OH2LAK/HamRef/docs/datasheets/OLED_0.91_I2C_proto/71N2hJt965L._SL1500_.jpg

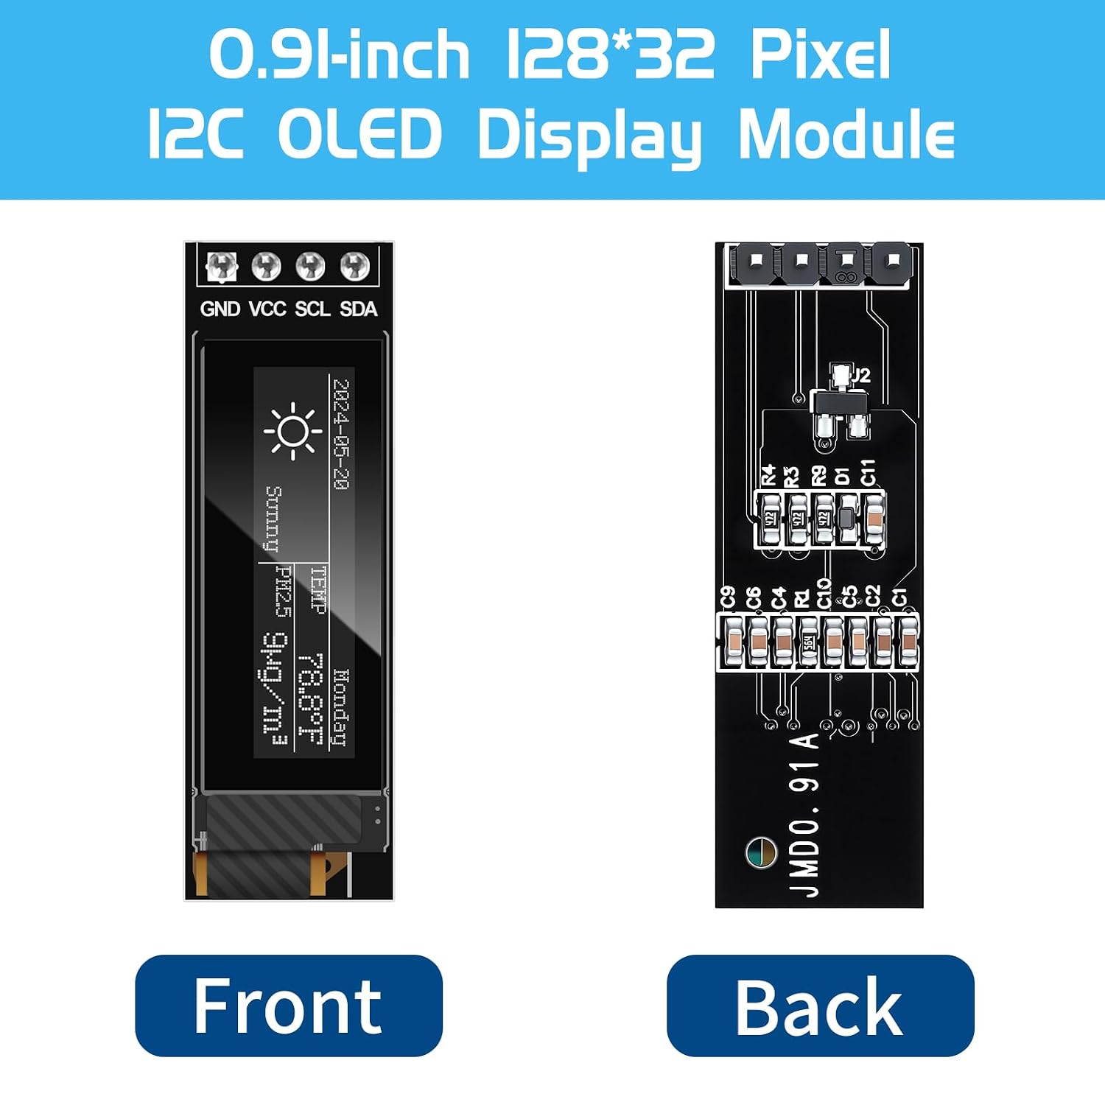
docs/datasheets/OLED_0.91_I2C_proto/71N2hJt965L._SL1500_.jpg
