OH2LAK/HamRef/docs/datasheets/OLED_0.91_I2C_proto/71uFmHMnJsL._SL1500_.jpg

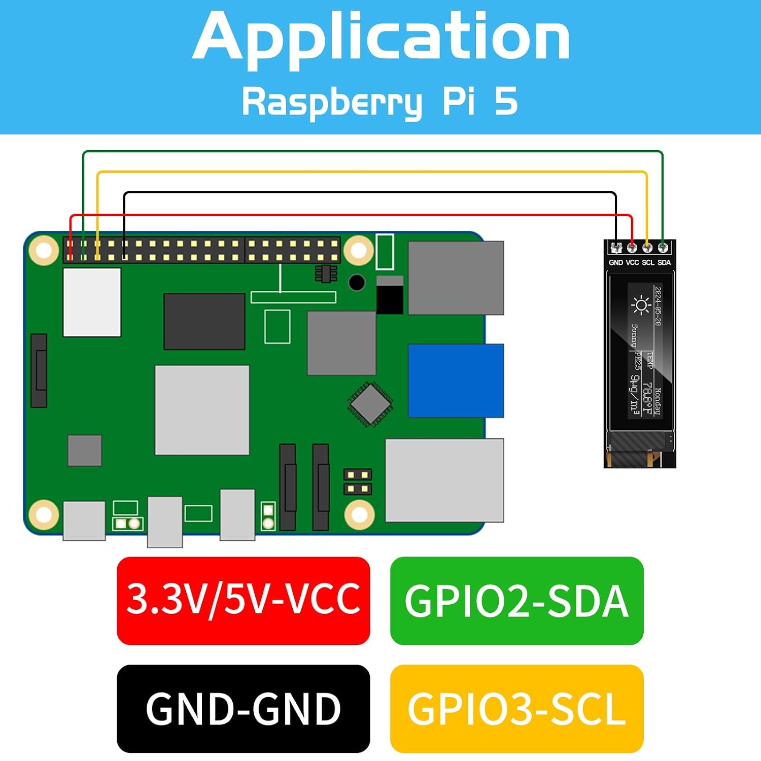
docs/datasheets/OLED_0.91_I2C_proto/71uFmHMnJsL._SL1500_.jpg
