OH2LAK/HamRef/docs/images/HamREF proto-1 PCB.png

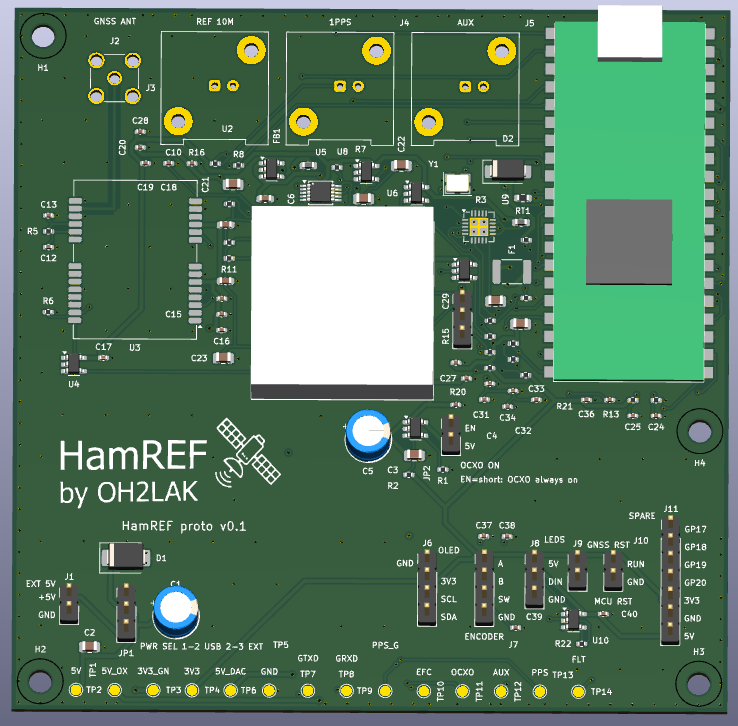
docs/images/HamREF proto-1 PCB.png
