OH2LAK/HamRef/hardware/proto-v0.1/hamref_proto_v0_1_schematic.pdf

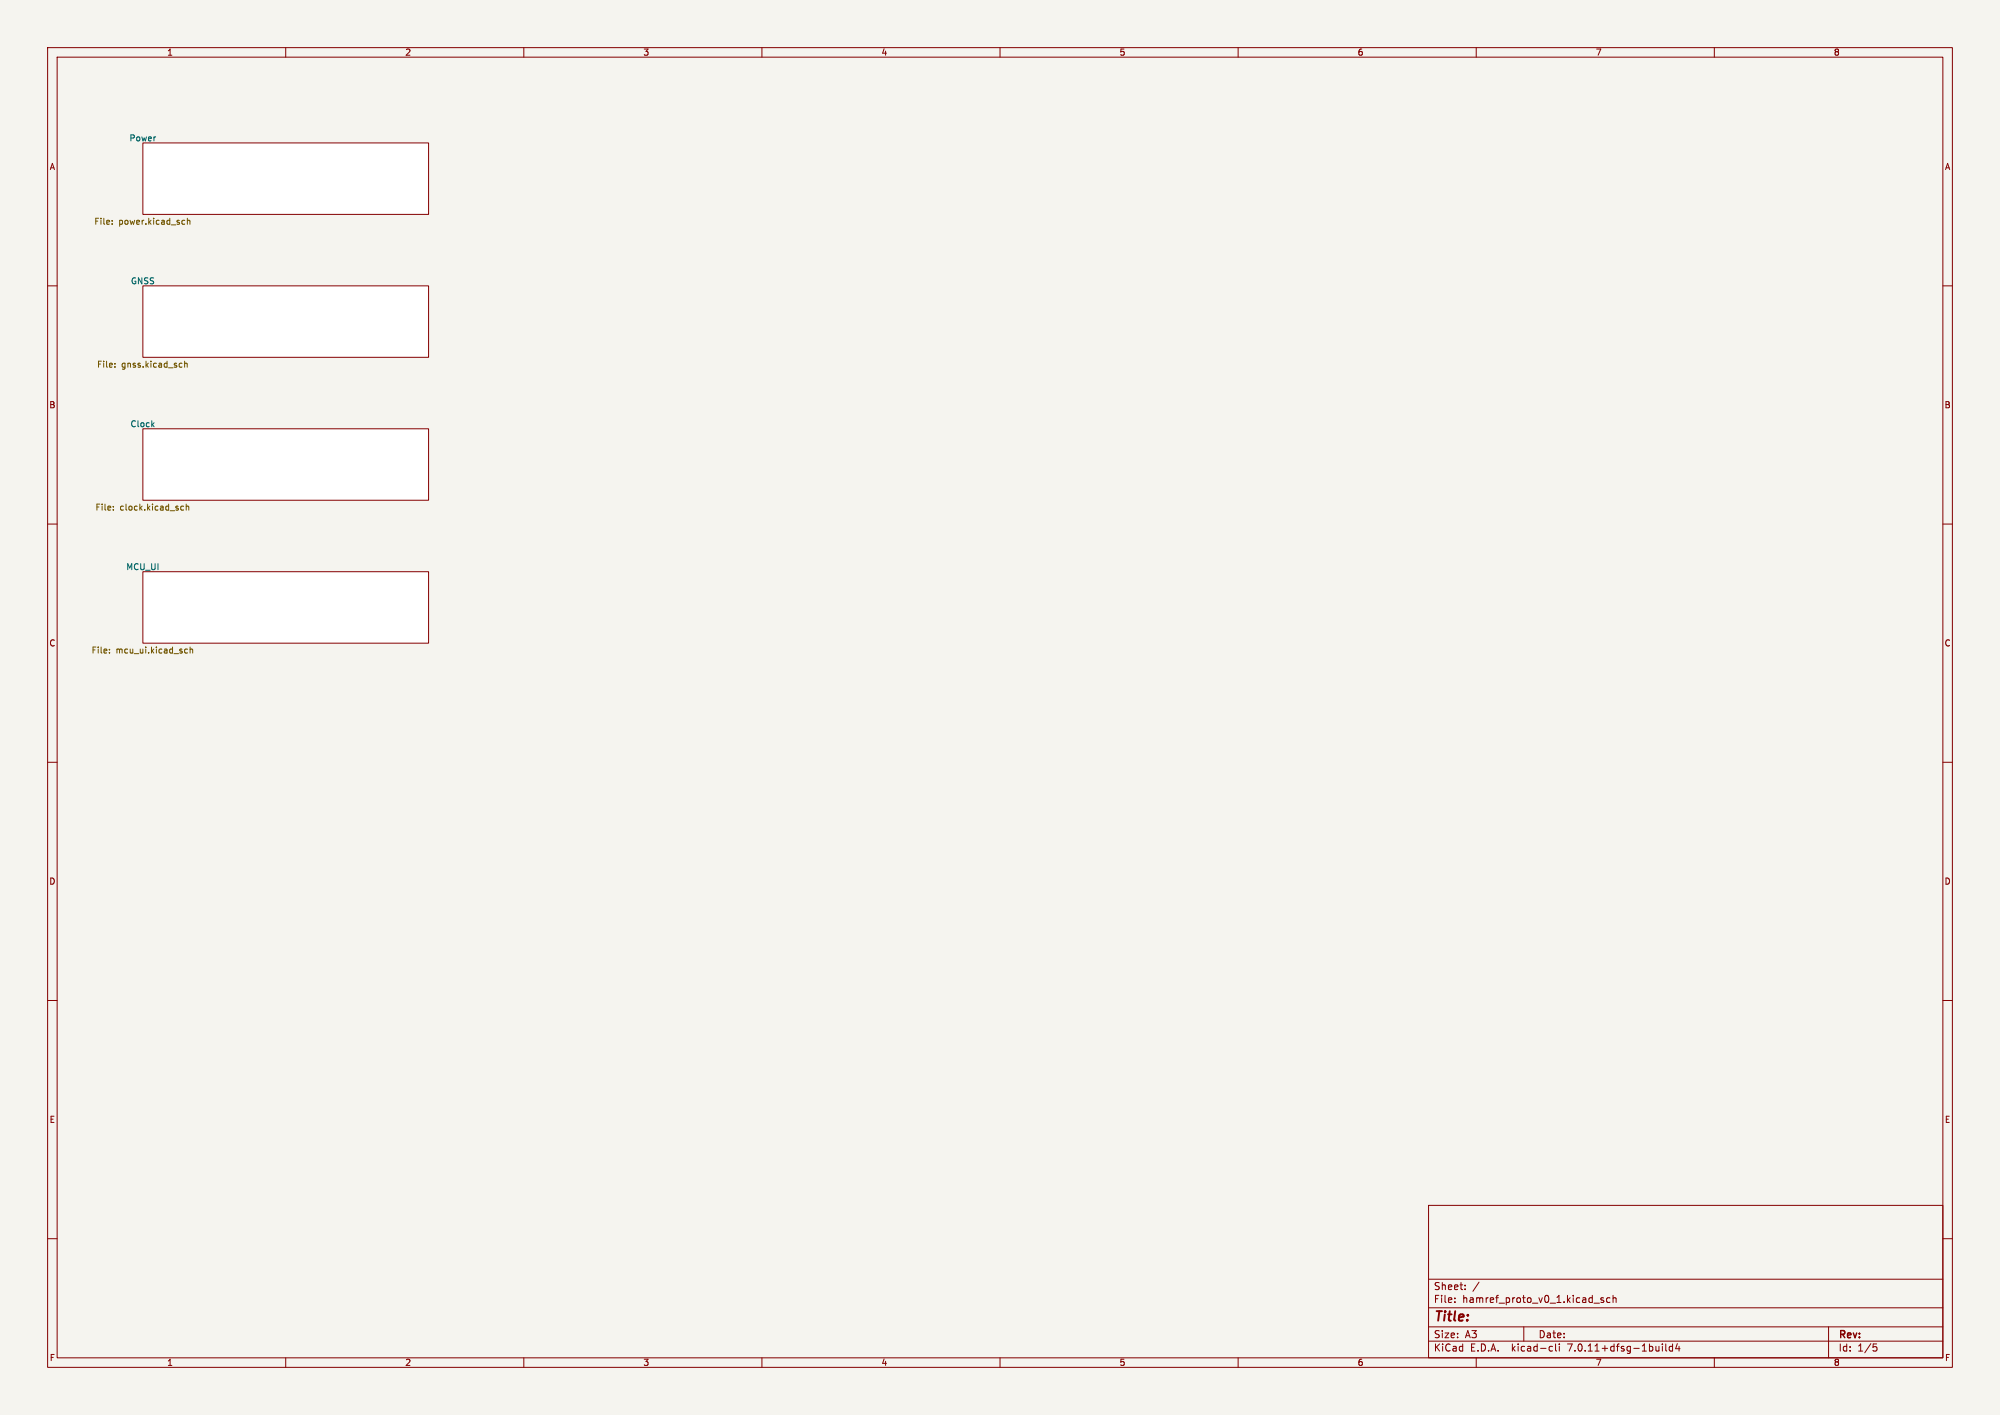
[picture p12: page 1]

Power File: power.kicad_sch GNSS

File: gnss.kicad_sch Clock File: clock.kicad_sch MCU_UI File: mcu_ui.kicad_sch

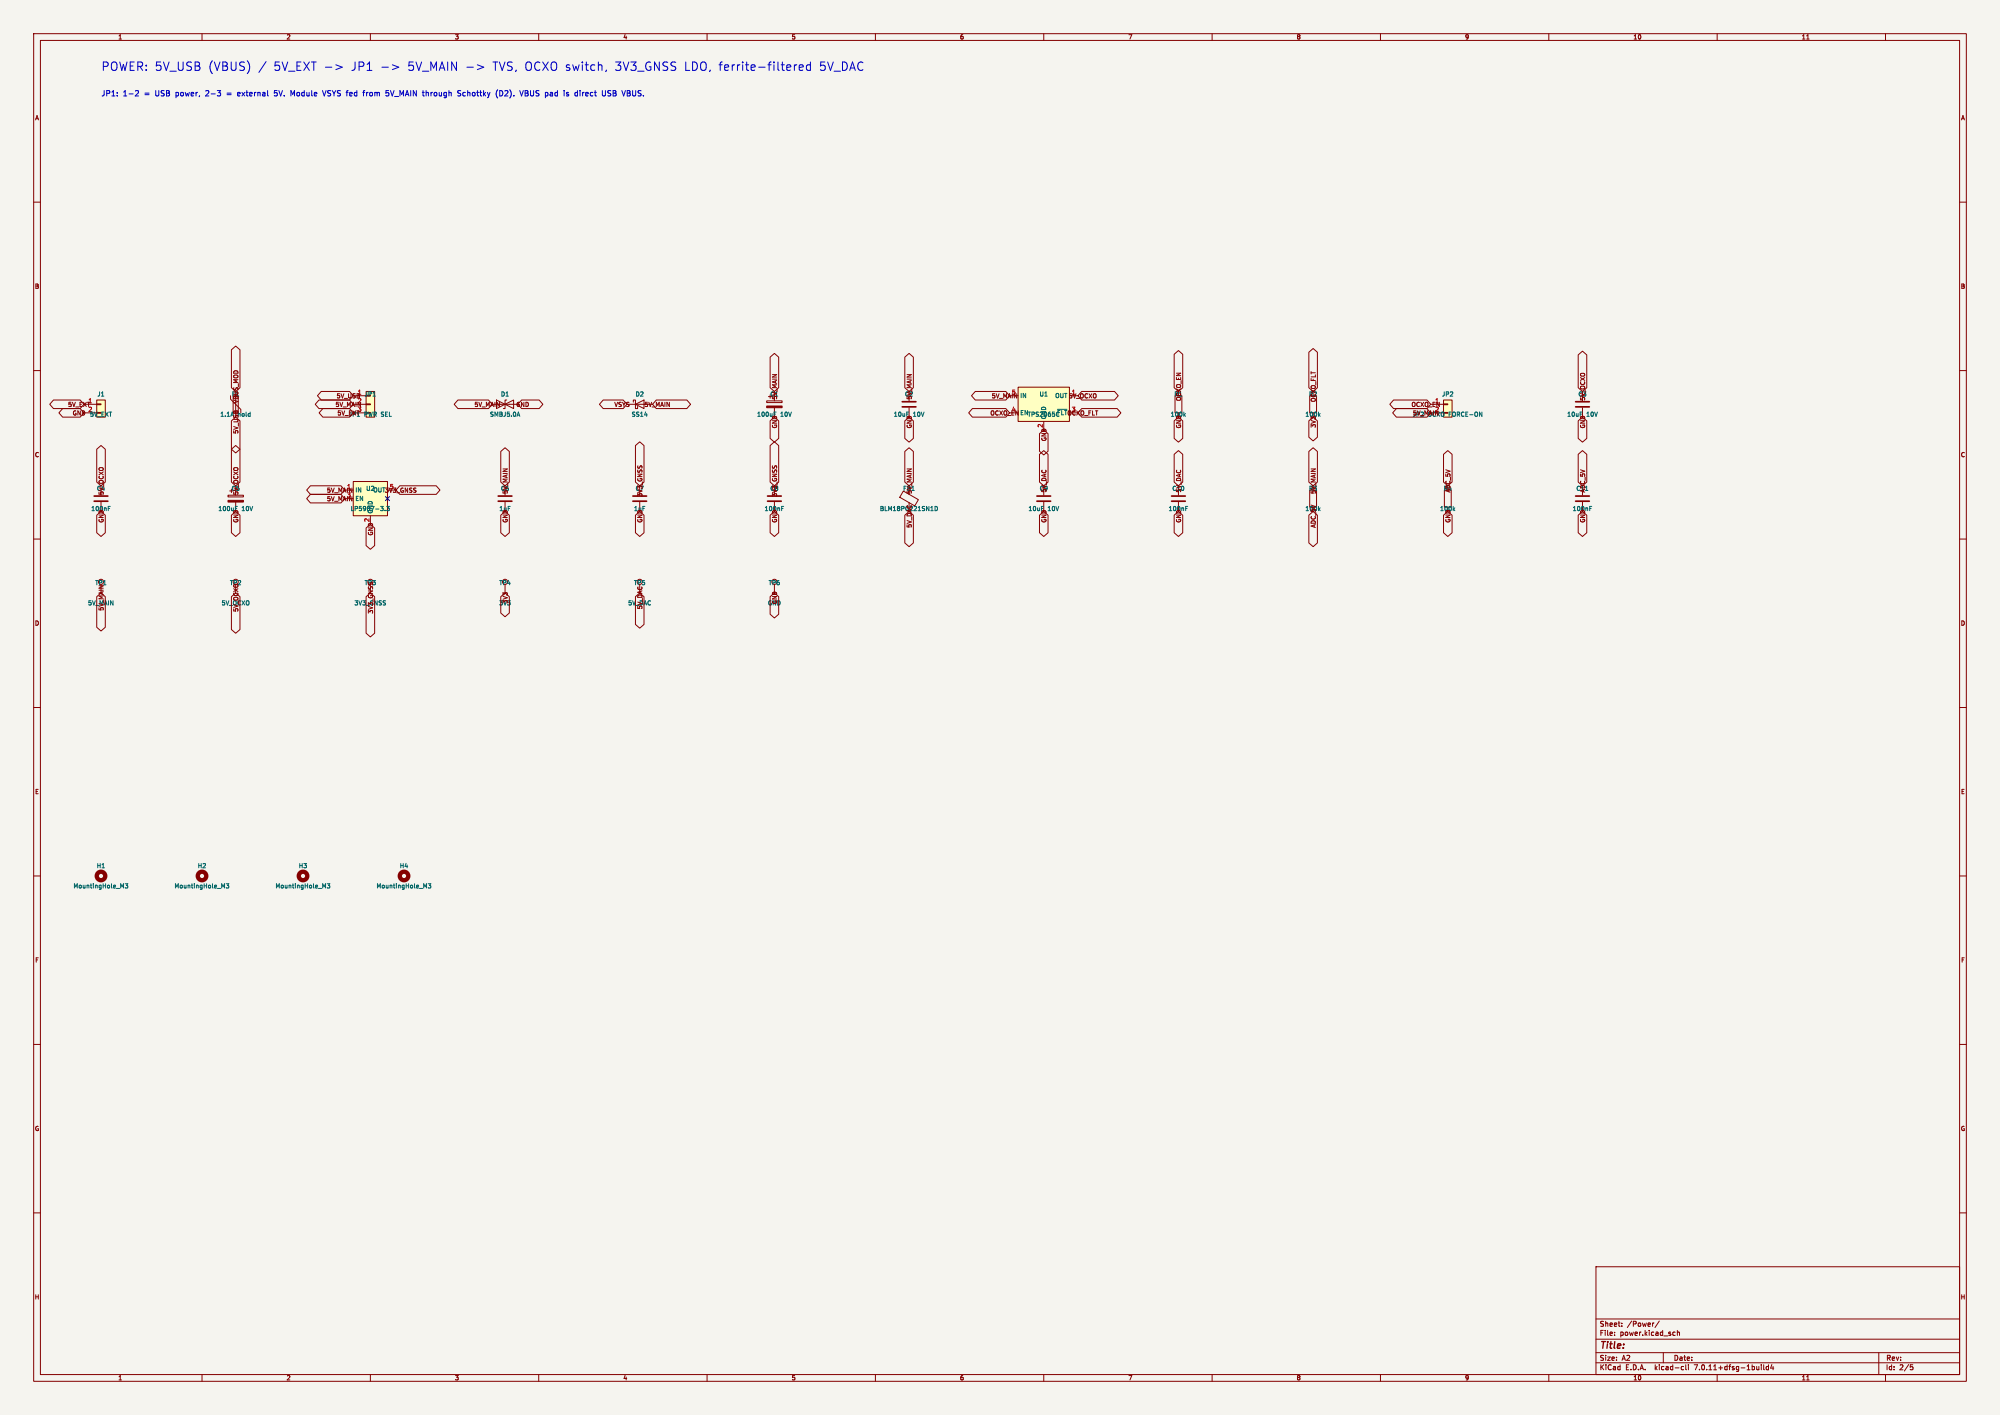
[picture p13: page 2]

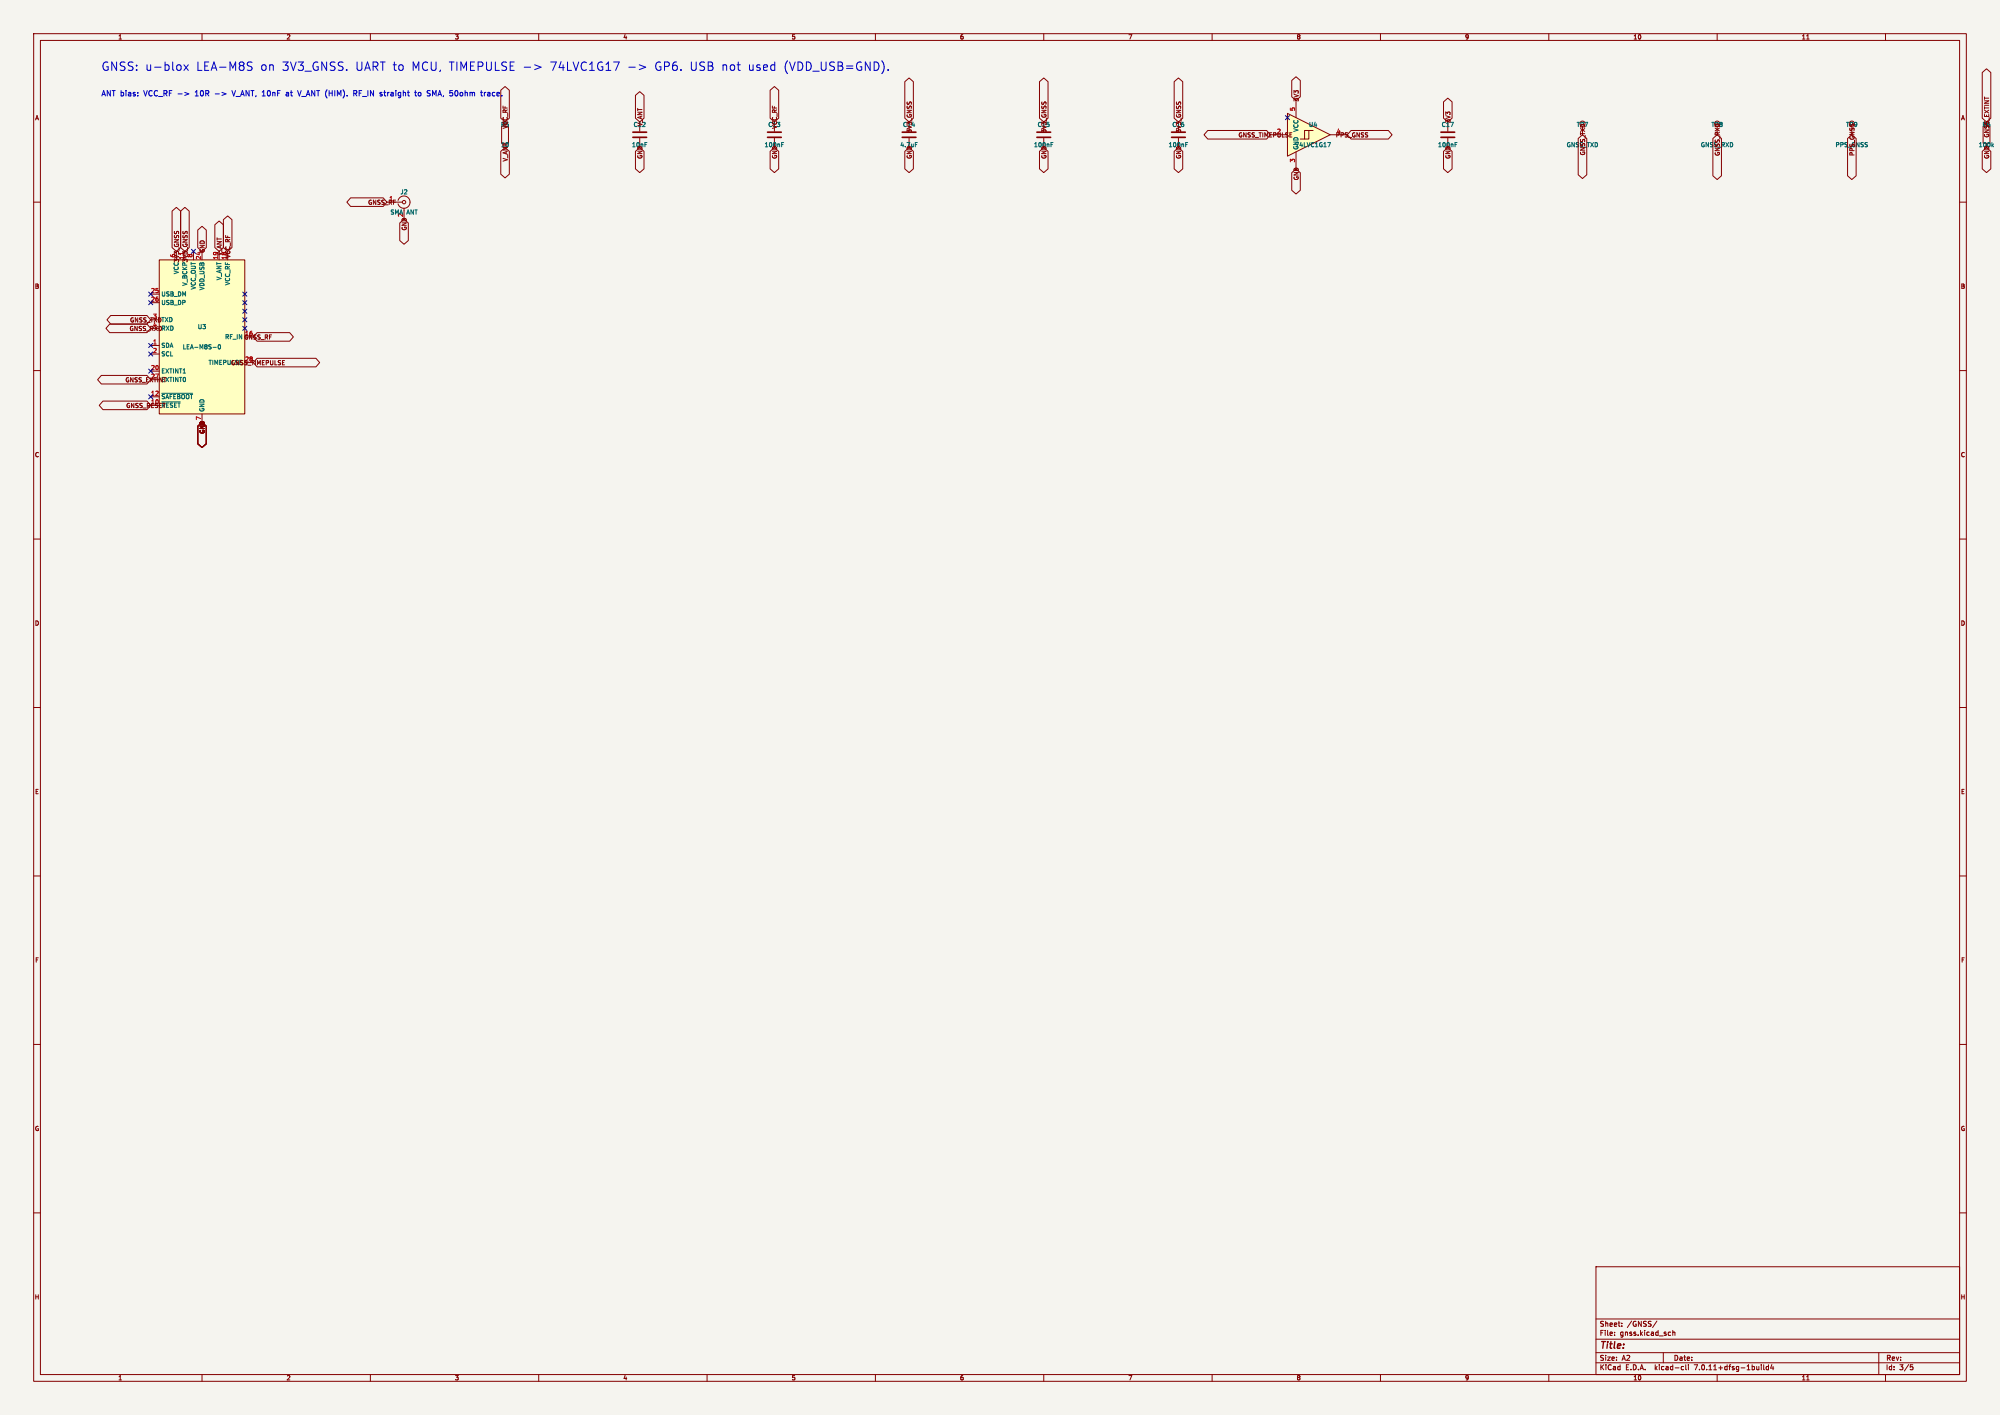
[picture p14: page 3]

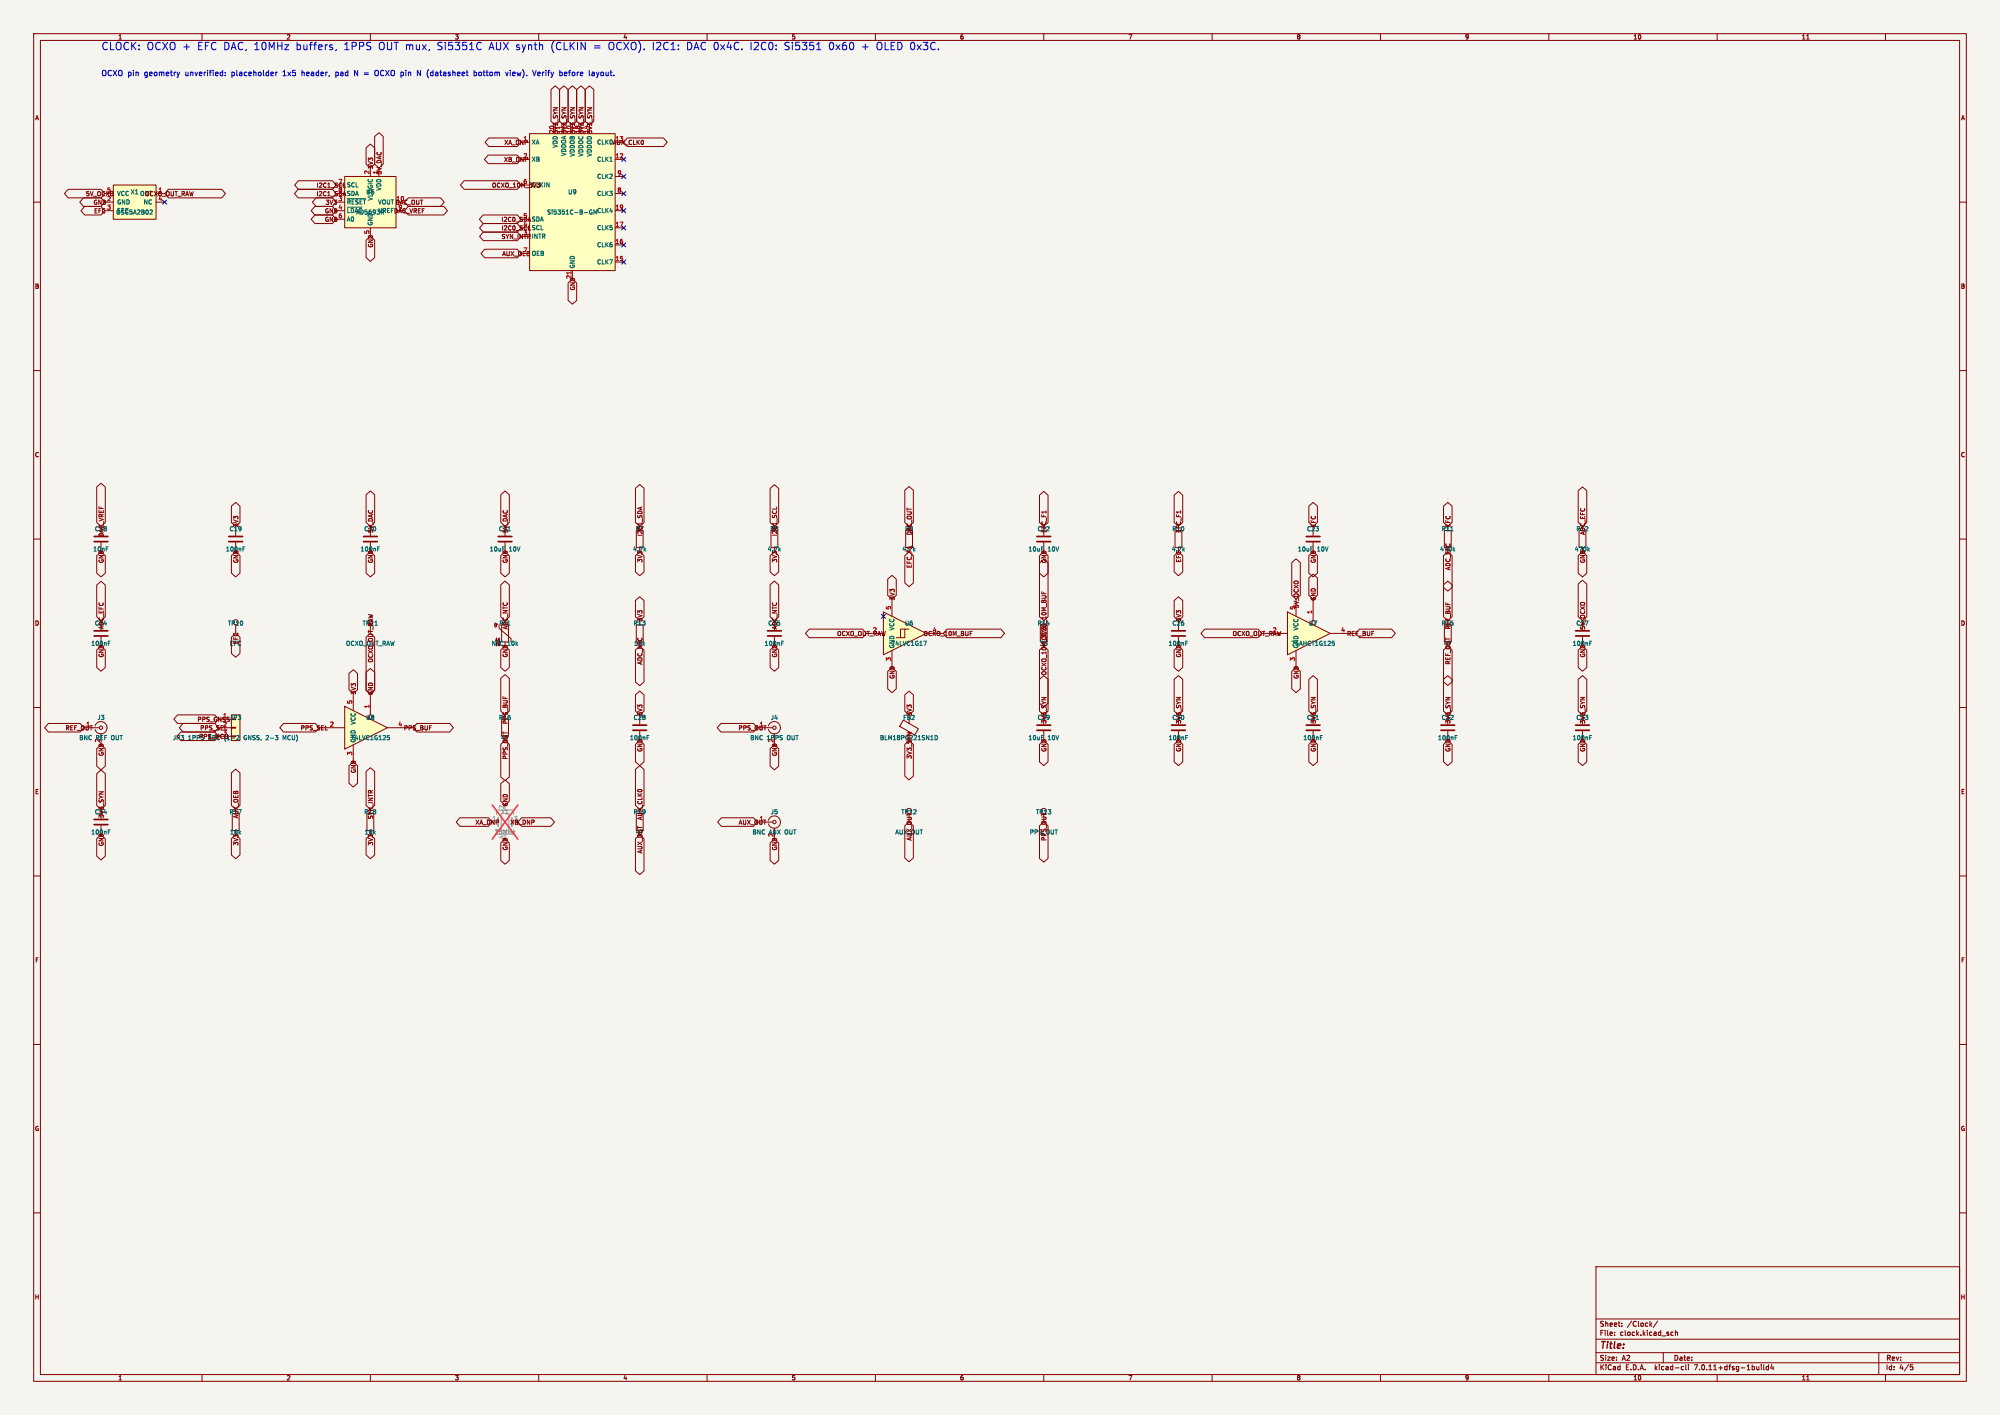
[picture p15: page 4]

CLOCK: OCXO + EFC DAC, 10MHz buffers, 1PPS OUT mux, Si5351C AUX synth (CLKIN = OCXO). I2C1: DAC 0x4C. I2C0: Si5351 0x60 + OLED 0x3C.

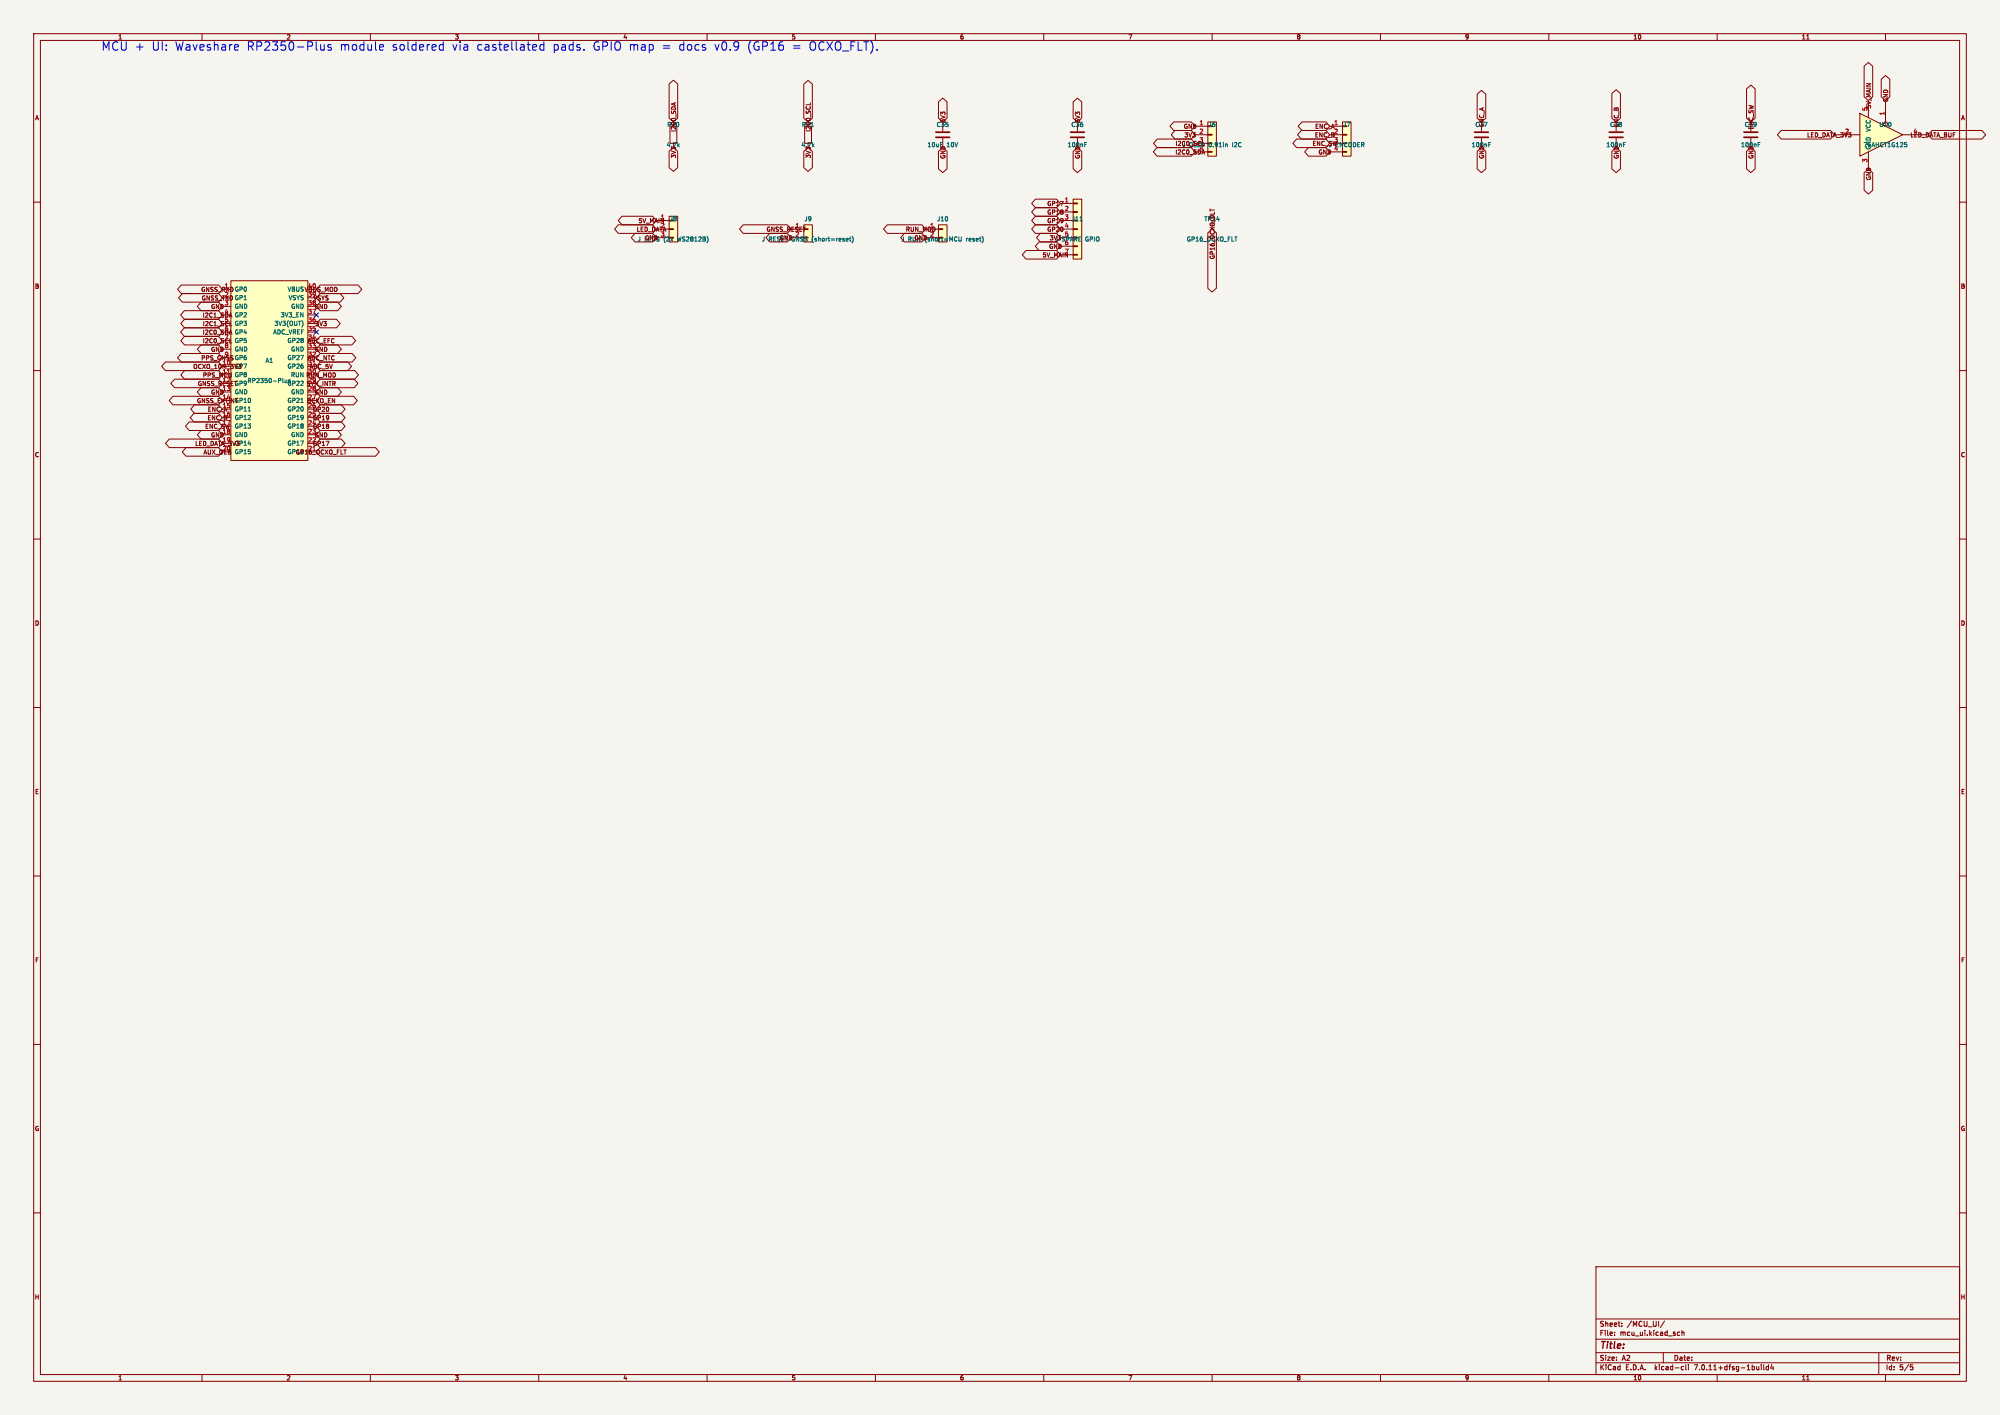
[picture p16: page 5]
