OH2LAK/HamRef/hardware/proto-v0.1/hamref_proto_v0_1_pcb.pdf

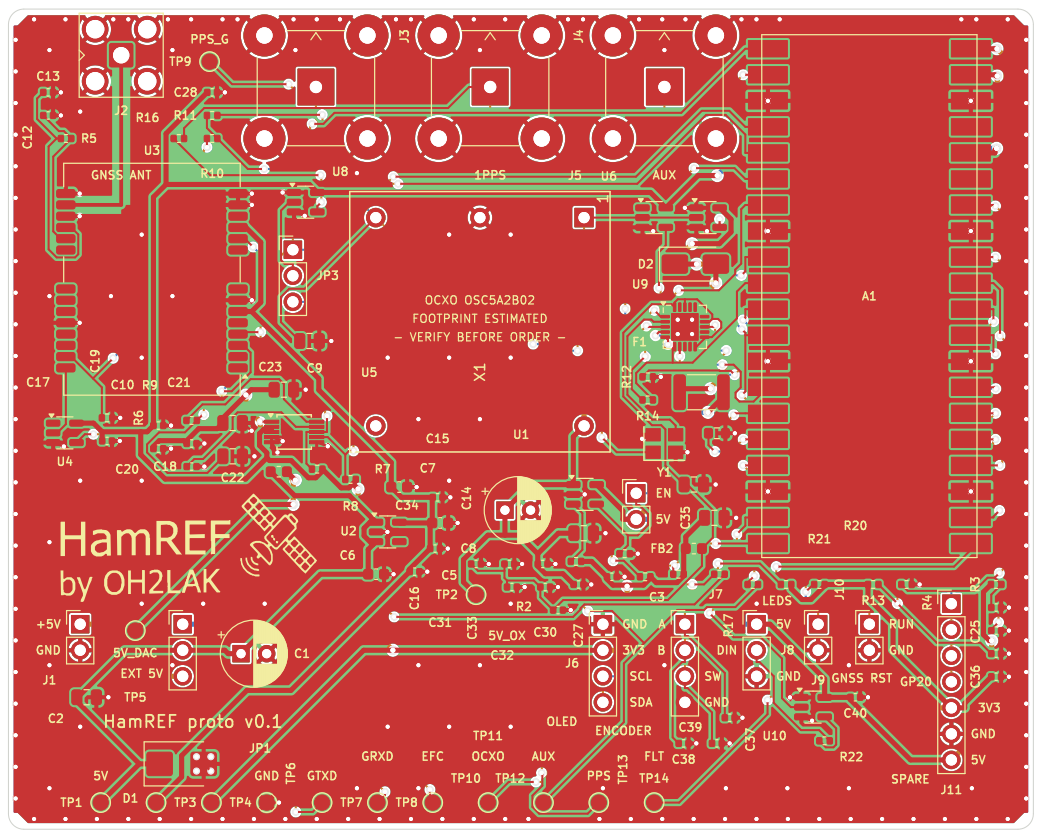
[picture p17: page 1]
