OH2LAK/HamRef/hardware/proto-v0.1/hamref_proto_v0_1.kicad_pcb

## KiCad design hardware/proto-v0.1/hamref_proto_v0_1.kicad_pcb (2026-10-14)

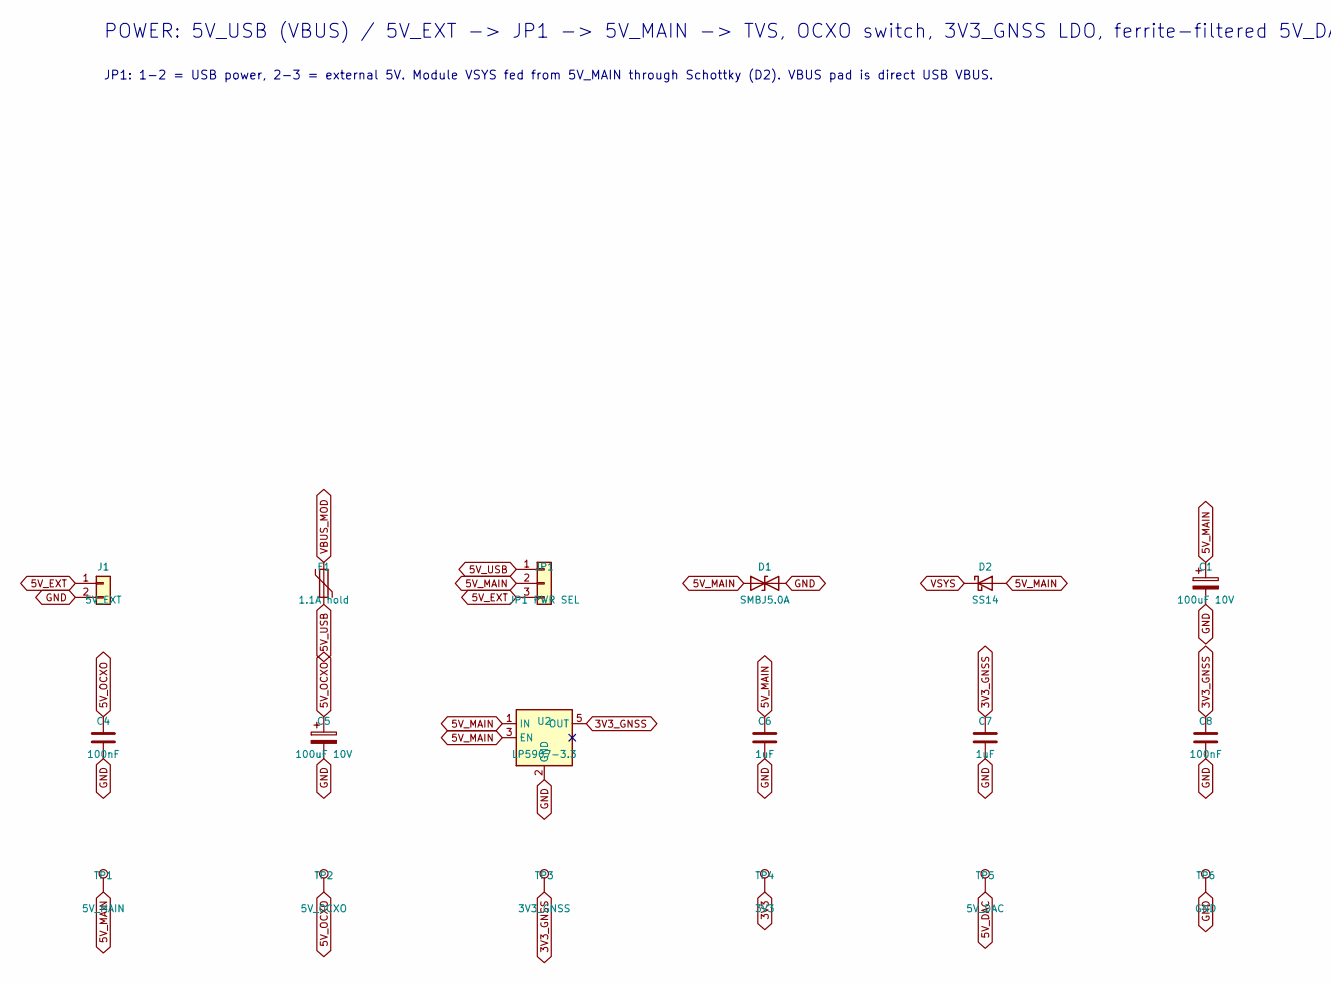
[picture p18: schematic power.kicad_sch, part in row 1, column 1]

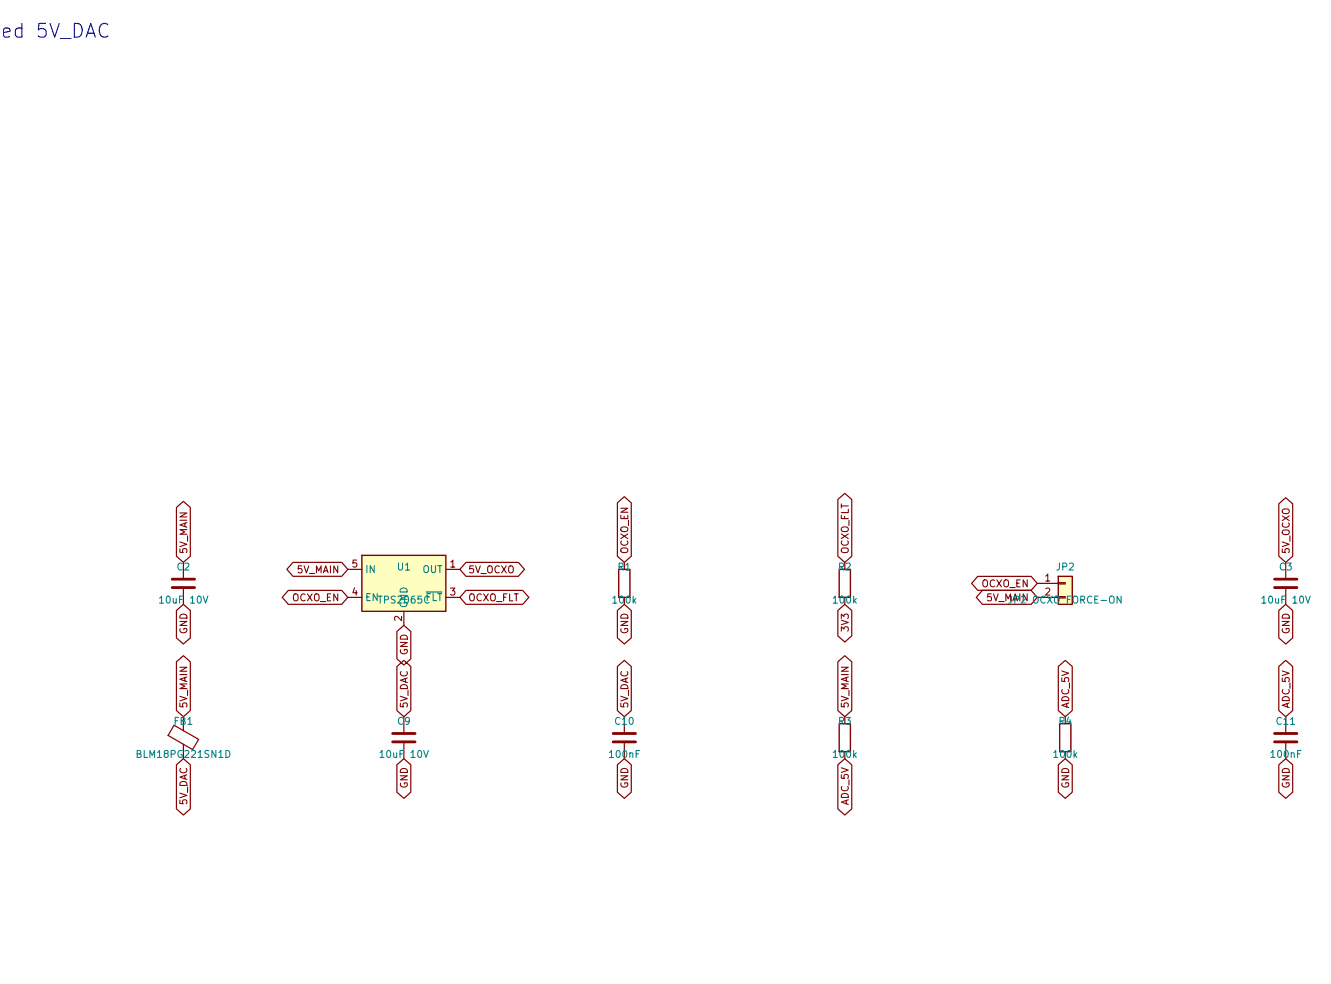
[picture p19: schematic power.kicad_sch, part in row 1, column 2]

Parts:
C1, C5: 100uF 10V; CP_Radial_D6.3mm_P2.50mm
C2, C3, C9: 10uF 10V; C_0805_2012Metric
C4, C8, C10, C11: 100nF; C_0402_1005Metric
C6, C7: 1uF; C_0603_1608Metric
D1: SMBJ5.0A; D_SMB; MPN SMBJ5.0A
D2: SS14; D_SMA; MPN SS14
F1: 1.1A hold; Fuse_1812_4532Metric; MPN MF-MSMF110/16X-2
FB1: BLM18PG221SN1D; L_0603_1608Metric; MPN BLM18PG221SN1D
J1: 5V_EXT; PinHeader_1x02_P2.54mm_Vertical
JP1: JP1 PWR SEL; PinHeader_1x03_P2.54mm_Vertical
JP2: JP2 OCXO FORCE-ON; PinHeader_1x02_P2.54mm_Vertical
R1, R2, R3, R4: 100k; R_0402_1005Metric
TP1: 5V_MAIN; TestPoint_Pad_D1.5mm
TP2: 5V_OCXO; TestPoint_Pad_D1.5mm
TP3: 3V3_GNSS; TestPoint_Pad_D1.5mm
TP4: 3V3; TestPoint_Pad_D1.5mm
TP5: 5V_DAC; TestPoint_Pad_D1.5mm
TP6: GND; TestPoint_Pad_D1.5mm
U1: TPS2065C; SOT-23-5; MPN TPS2065CDBVR
U2: LP5907-3.3; SOT-23-5; MPN LP5907MFX-3.3/NOPB

Connections:
3V3: R2.2, TP4.1; also elsewhere on the board
3V3_GNSS: C7.1, C8.1, TP3.1, U2.5 (OUT); also elsewhere on the board
5V_DAC: C9.1, C10.1, FB1.2, TP5.1; also elsewhere on the board
5V_EXT: J1.1, JP1.3
5V_MAIN: C1.1, C2.1, C6.1, D1.1 (A1), D2.2 (A), FB1.1, JP1.2, JP2.2, R3.1, TP1.1, U1.5 (IN), U2.1 (IN), U2.3 (EN); also elsewhere on the board
5V_OCXO: C3.1, C4.1, C5.1, TP2.1, U1.1 (OUT); also elsewhere on the board
5V_USB: F1.2, JP1.1
ADC_5V: C11.1, R3.2, R4.1; also elsewhere on the board
GND: C1.2, C2.2, C3.2, C4.2, C5.2, C6.2, C7.2, C8.2, C9.2, C10.2, C11.2, D1.2 (A2), J1.2, R1.2, R4.2, TP6.1, U1.2 (GND), U2.2 (GND); also elsewhere on the board
OCXO_EN: JP2.1, R1.1, U1.4 (EN); also elsewhere on the board
OCXO_FLT: R2.1, U1.3 (~FLT)
VBUS_MOD: F1.1; also elsewhere on the board
VSYS: D2.1 (K); also elsewhere on the board

Notes on the sheet:
POWER: 5V_USB (VBUS) / 5V_EXT -> JP1 -> 5V_MAIN -> TVS, OCXO switch, 3V3_GNSS LDO, ferrite-filtered 5V_DAC
JP1: 1-2 = USB power, 2-3 = external 5V. Module VSYS fed from 5V_MAIN through Schottky (D2). VBUS pad is direct USB VBUS.

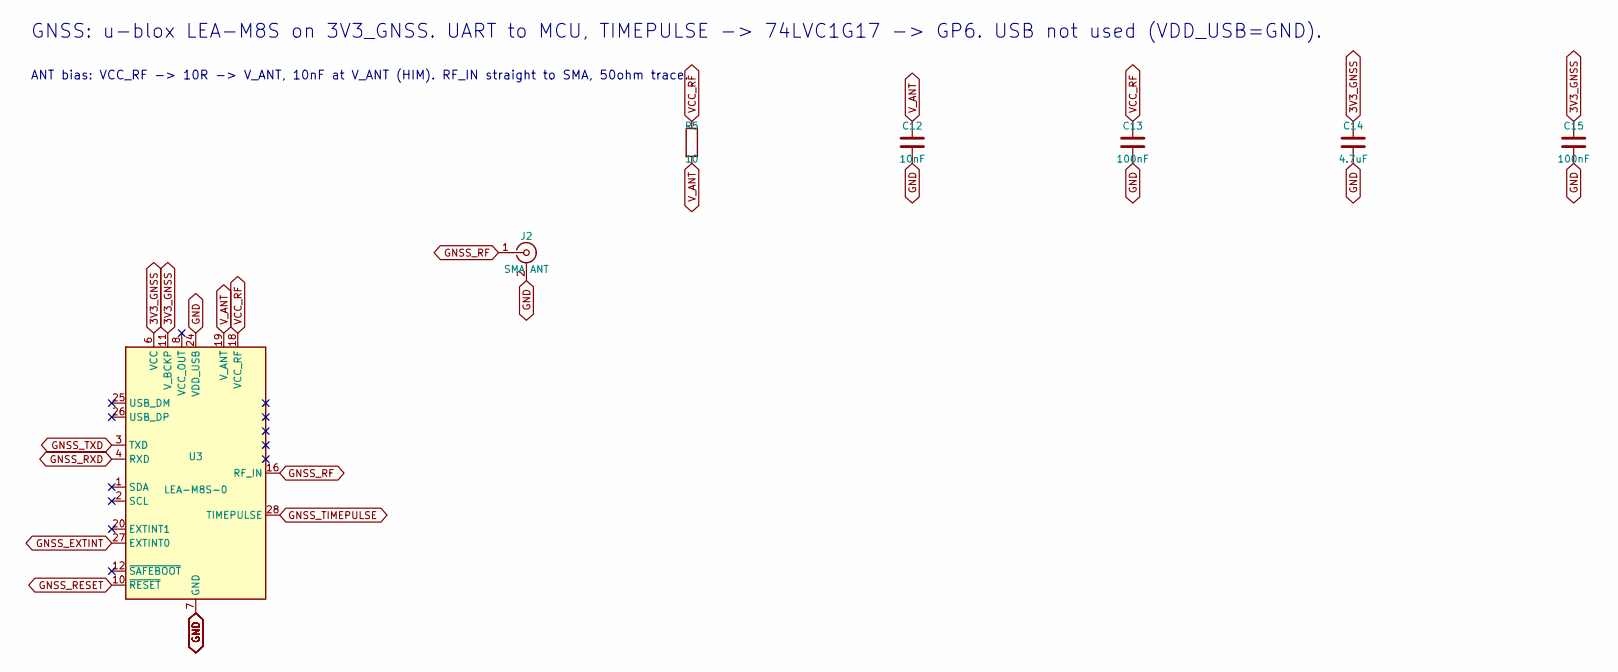
[picture p20: schematic gnss.kicad_sch, part in row 1, column 1]

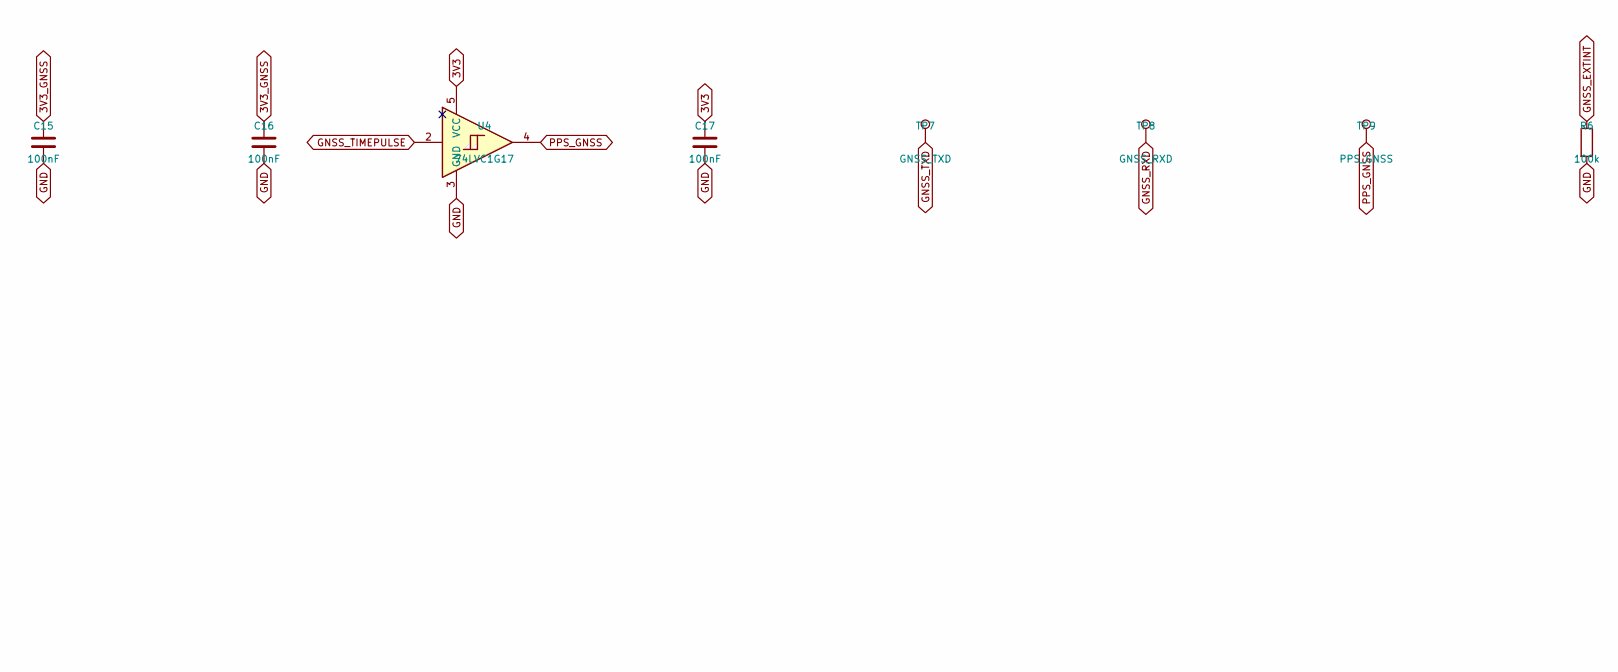
[picture p21: schematic gnss.kicad_sch, part in row 1, column 2]

Parts:
C12: 10nF; C_0402_1005Metric
C13, C15, C16, C17: 100nF; C_0402_1005Metric
C14: 4.7uF; C_0603_1608Metric
J2: SMA ANT; SMA_Amphenol_901-143_Horizontal; MPN 901-143
R5: 10; R_0402_1005Metric
R6: 100k; R_0402_1005Metric
TP7: GNSS_TXD; TestPoint_Pad_D1.5mm
TP8: GNSS_RXD; TestPoint_Pad_D1.5mm
TP9: PPS_GNSS; TestPoint_Pad_D1.5mm
U3: LEA-M8S-0; ublox_LEA; MPN LEA-M8S-0-10
U4: 74LVC1G17; SOT-23-5; MPN SN74LVC1G17DBVR

Connections:
3V3: C17.1, U4.5 (VCC); also elsewhere on the board
3V3_GNSS: C14.1, C15.1, C16.1, U3.6 (VCC), U3.11 (V_BCKP); also elsewhere on the board
GND: C12.2, C13.2, C14.2, C15.2, C16.2, C17.2, J2.2 (Ext), R6.2, U3.7 (GND), U3.13 (GND), U3.14 (GND), U3.15 (GND), U3.17 (GND), U3.24 (VDD_USB), U4.3 (GND); also elsewhere on the board
GNSS_EXTINT: R6.1, U3.27 (EXTINT0); also elsewhere on the board
GNSS_RESET: U3.10 (~RESET); also elsewhere on the board
GNSS_RF: J2.1 (In), U3.16 (RF_IN)
GNSS_RXD: TP8.1, U3.4 (RXD); also elsewhere on the board
GNSS_TIMEPULSE: U3.28 (TIMEPULSE), U4.2
GNSS_TXD: TP7.1, U3.3 (TXD); also elsewhere on the board
PPS_GNSS: TP9.1, U4.4; also elsewhere on the board
VCC_RF: C13.1, R5.1, U3.18 (VCC_RF)
V_ANT: C12.1, R5.2, U3.19 (V_ANT)

Notes on the sheet:
GNSS: u-blox LEA-M8S on 3V3_GNSS. UART to MCU, TIMEPULSE -> 74LVC1G17 -> GP6. USB not used (VDD_USB=GND).
ANT bias: VCC_RF -> 10R -> V_ANT, 10nF at V_ANT (HIM). RF_IN straight to SMA, 50ohm trace.

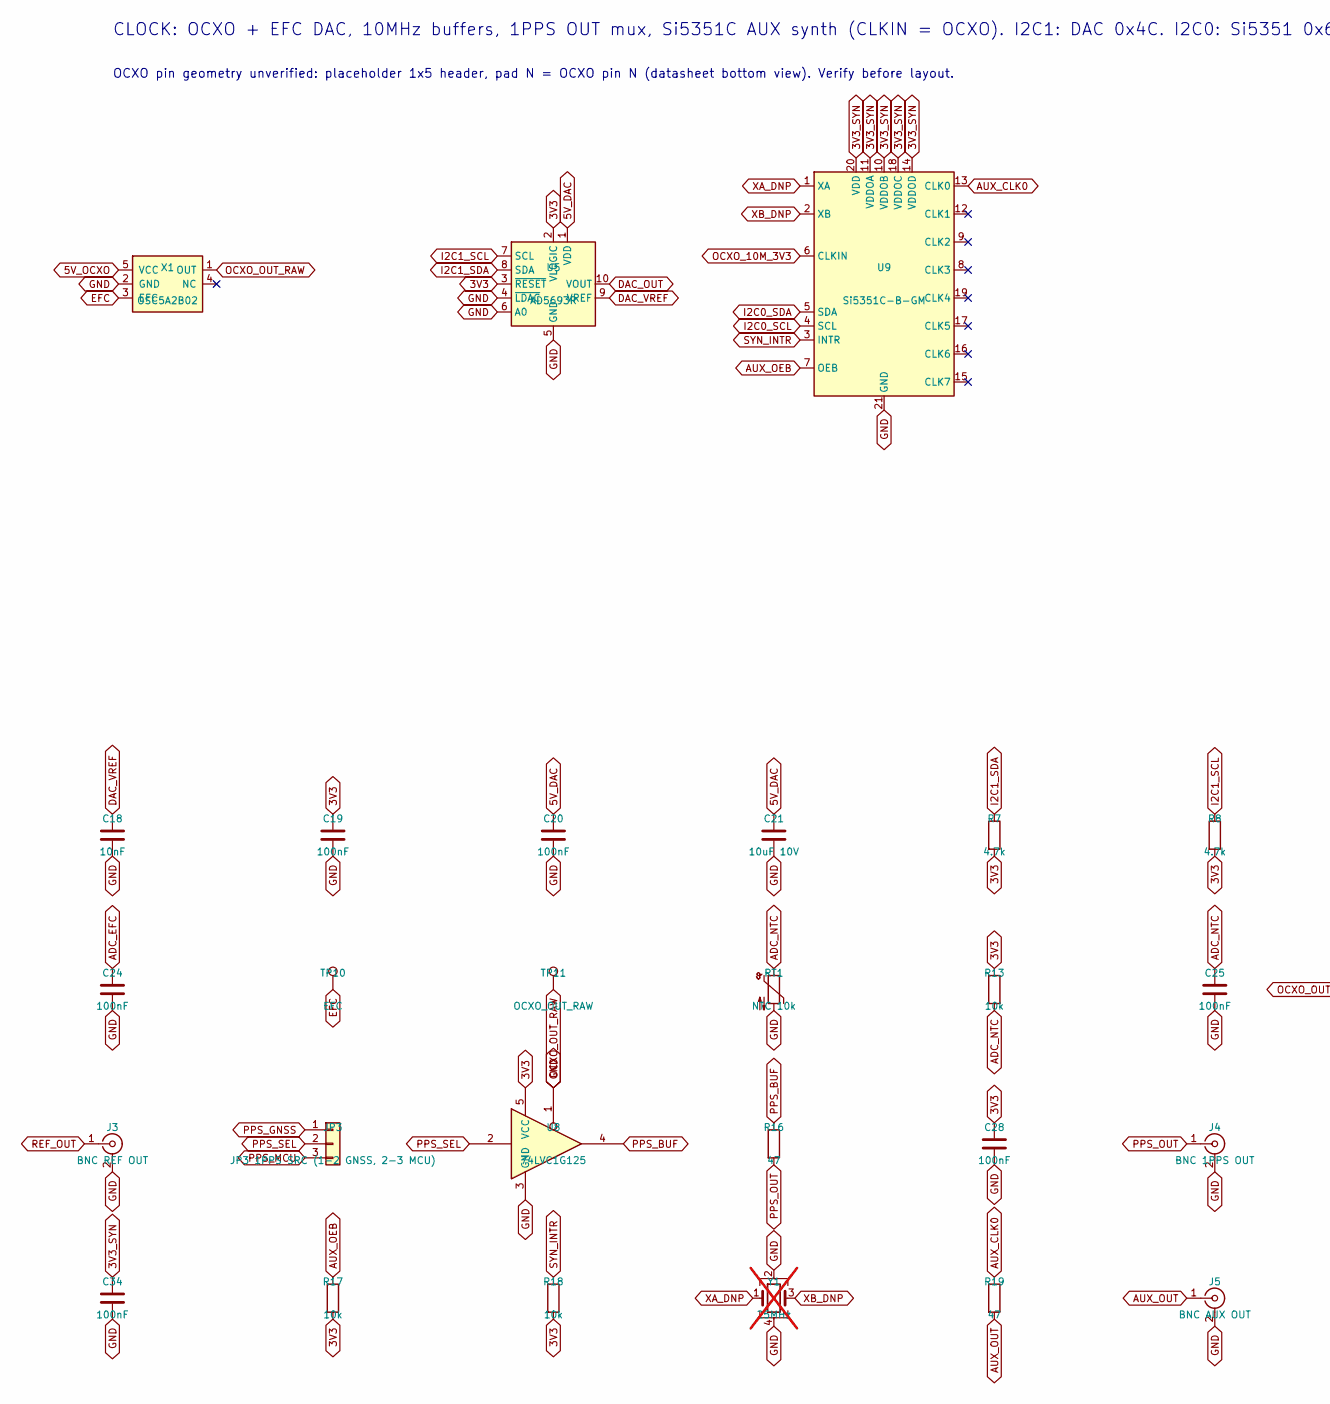
[picture p22: schematic clock.kicad_sch, part in row 1, column 1]

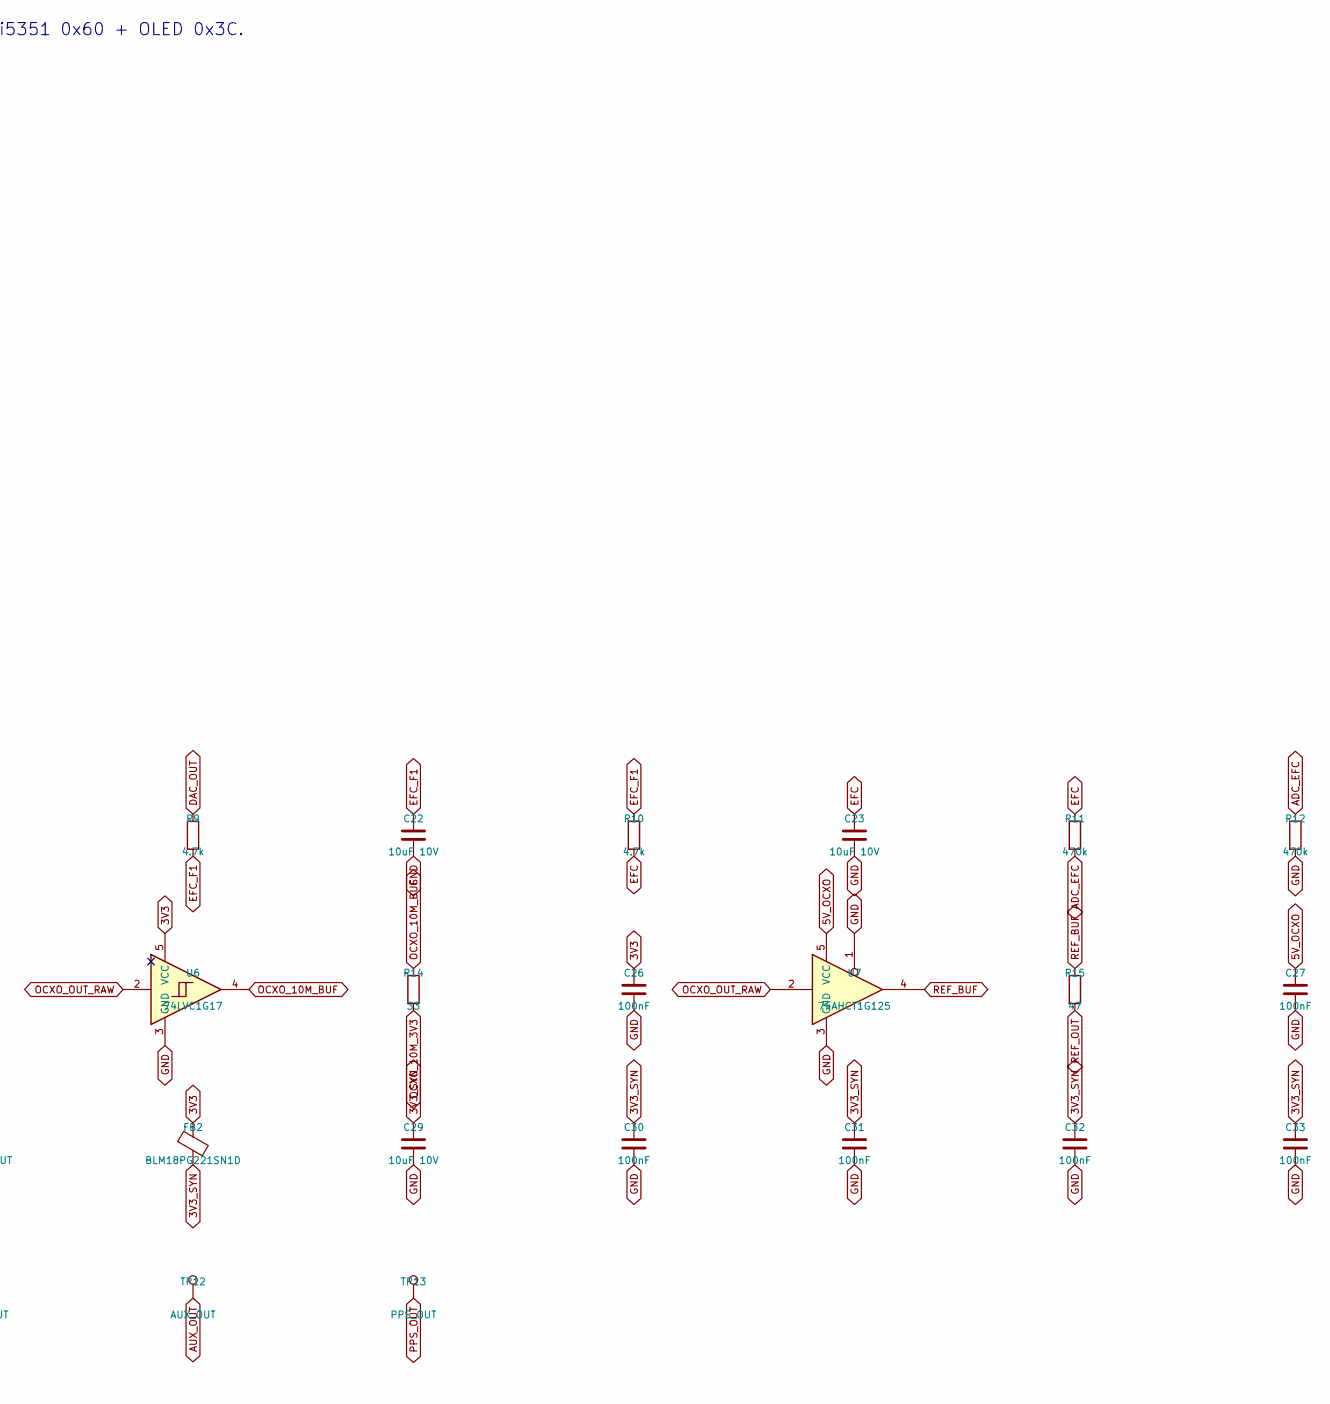
[picture p23: schematic clock.kicad_sch, part in row 1, column 2]

Parts:
C18: 10nF; C_0402_1005Metric
C19, C20, C24, C25, C26, C27, C28, C30, C31, C32, C33, C34: 100nF; C_0402_1005Metric
C21, C22, C23, C29: 10uF 10V; C_0805_2012Metric
FB2: BLM18PG221SN1D; L_0603_1608Metric; MPN BLM18PG221SN1D
J3: BNC REF OUT; BNC_TEConnectivity_1478035_Horizontal; MPN 1-1478035-0
J4: BNC 1PPS OUT; BNC_TEConnectivity_1478035_Horizontal; MPN 1-1478035-0
J5: BNC AUX OUT; BNC_TEConnectivity_1478035_Horizontal; MPN 1-1478035-0
JP3: JP3 1PPS SRC (1-2 GNSS, 2-3 MCU); PinHeader_1x03_P2.54mm_Vertical
R7, R8, R9, R10: 4.7k; R_0402_1005Metric
R11, R12: 470k; R_0402_1005Metric
R13, R17, R18: 10k; R_0402_1005Metric
R14: 33; R_0402_1005Metric
R15, R16, R19: 47; R_0402_1005Metric
RT1: NTC 10k; R_0603_1608Metric; MPN NCP18XH103F03RB
TP10: EFC; TestPoint_Pad_D1.5mm
TP11: OCXO_OUT_RAW; TestPoint_Pad_D1.5mm
TP12: AUX_OUT; TestPoint_Pad_D1.5mm
TP13: PPS_OUT; TestPoint_Pad_D1.5mm
U5: AD5693R; MSOP-10_3x3mm_P0.5mm; MPN AD5693RBRMZ
U6: 74LVC1G17; SOT-23-5; MPN SN74LVC1G17DBVR
U7: 74AHCT1G125; SOT-23-5; MPN SN74AHCT1G125DBVR
U8: 74LVC1G125; SOT-23-5; MPN SN74LVC1G125DBVR
U9: Si5351C-B-GM; QFN-20-1EP_4x4mm_P0.5mm_EP2.6x2.6mm; MPN SI5351C-B-GM
X1: OSC5A2B02; OCXO_OSC5A2B02_EST; MPN OSC5A2B02
Y1: 25MHz; Crystal_SMD_3225-4Pin_3.2x2.5mm; not fitted

Connections:
3V3: C19.1, C26.1, C28.1, FB2.1, R7.2, R8.2, R13.1, R17.2, R18.2, U5.2 (VLOGIC), U5.3 (~RESET), U6.5 (VCC), U8.5 (VCC); also elsewhere on the board
3V3_SYN: C29.1, C30.1, C31.1, C32.1, C33.1, C34.1, FB2.2, U9.10 (VDDOB), U9.11 (VDDOA), U9.14 (VDDOD), U9.18 (VDDOC), U9.20 (VDD)
5V_DAC: C20.1, C21.1, U5.1 (VDD); also elsewhere on the board
5V_OCXO: C27.1, U7.5 (VCC), X1.5 (VCC); also elsewhere on the board
ADC_EFC: C24.1, R11.2, R12.1; also elsewhere on the board
ADC_NTC: C25.1, R13.2, RT1.1; also elsewhere on the board
AUX_CLK0: R19.1, U9.13 (CLK0)
AUX_OEB: R17.1, U9.7 (OEB); also elsewhere on the board
AUX_OUT: J5.1 (In), R19.2, TP12.1
DAC_OUT: R9.1, U5.10 (VOUT)
DAC_VREF: C18.1, U5.9 (VREF)
EFC: C23.1, R10.2, R11.1, TP10.1, X1.3 (EFC)
EFC_F1: C22.1, R9.2, R10.1
GND: C18.2, C19.2, C20.2, C21.2, C22.2, C23.2, C24.2, C25.2, C26.2, C27.2, C28.2, C29.2, C30.2, C31.2, C32.2, C33.2, C34.2, J3.2 (Ext), J4.2 (Ext), J5.2 (Ext), R12.2, RT1.2, U5.4 (~LDAC), U5.5 (GND), U5.6 (A0), U6.3 (GND), U7.1, U7.3 (GND), U8.1, U8.3 (GND), U9.21 (GND), X1.2 (GND), Y1.2, Y1.4; also elsewhere on the board
I2C0_SCL: U9.4 (SCL); also elsewhere on the board
I2C0_SDA: U9.5 (SDA); also elsewhere on the board
I2C1_SCL: R8.1, U5.7 (SCL); also elsewhere on the board
I2C1_SDA: R7.1, U5.8 (SDA); also elsewhere on the board
OCXO_10M_3V3: R14.2, U9.6 (CLKIN); also elsewhere on the board
OCXO_10M_BUF: R14.1, U6.4
OCXO_OUT_RAW: TP11.1, U6.2, U7.2, X1.1 (OUT)
PPS_BUF: R16.1, U8.4
PPS_GNSS: JP3.1; also elsewhere on the board
PPS_MCU: JP3.3; also elsewhere on the board
PPS_OUT: J4.1 (In), R16.2, TP13.1
PPS_SEL: JP3.2, U8.2
REF_BUF: R15.1, U7.4
REF_OUT: J3.1 (In), R15.2
SYN_INTR: R18.1, U9.3 (INTR); also elsewhere on the board
XA_DNP: U9.1 (XA), Y1.1
XB_DNP: U9.2 (XB), Y1.3

Notes on the sheet:
CLOCK: OCXO + EFC DAC, 10MHz buffers, 1PPS OUT mux, Si5351C AUX synth (CLKIN = OCXO). I2C1: DAC 0x4C. I2C0: Si5351 0x60 + OLED 0x3C.
OCXO pin geometry unverified: placeholder 1x5 header, pad N = OCXO pin N (datasheet bottom view). Verify before layout.

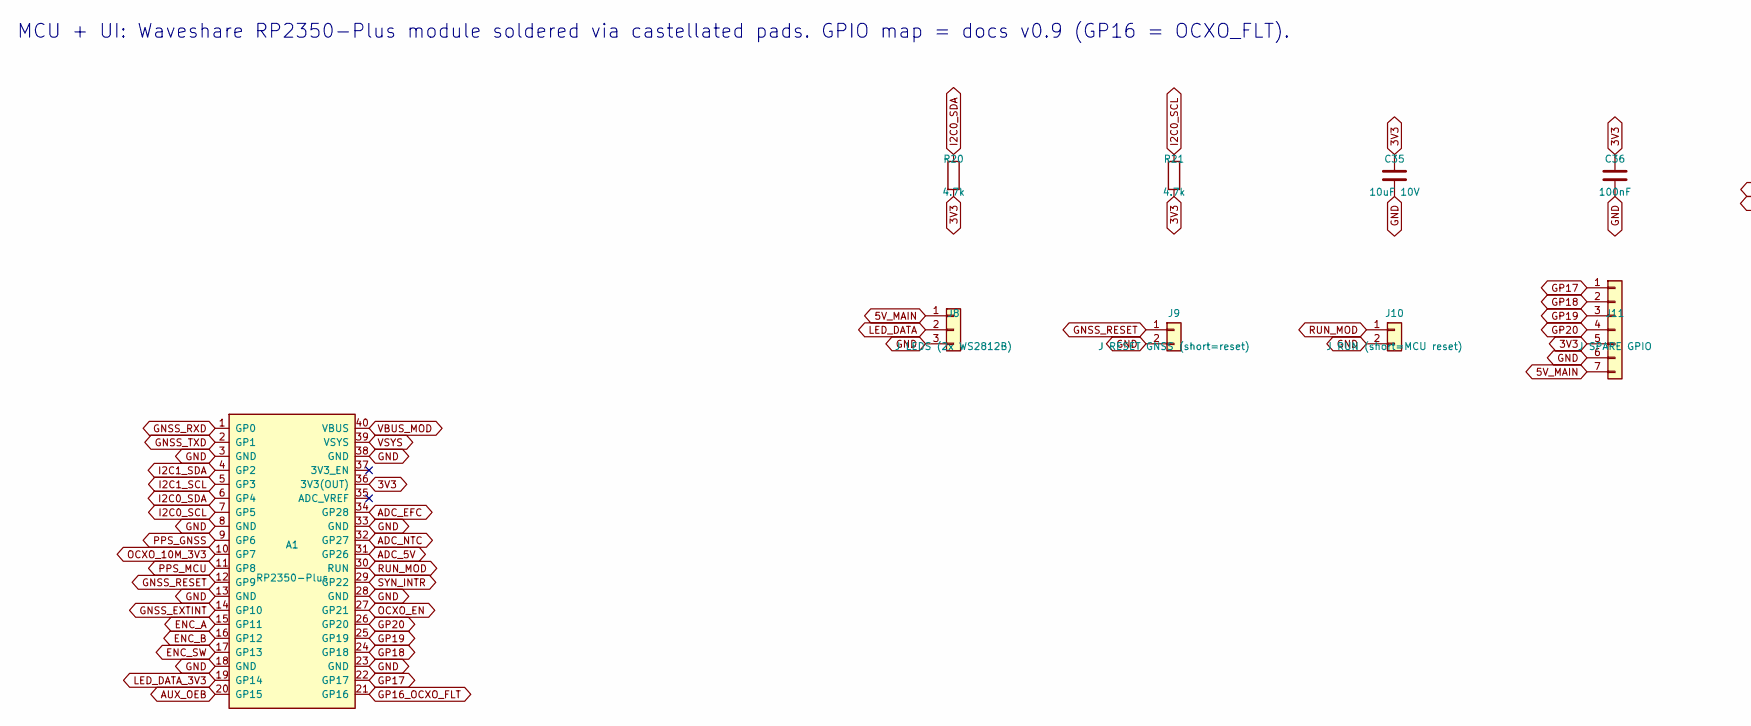
[picture p24: schematic mcu_ui.kicad_sch, part in row 1, column 1]

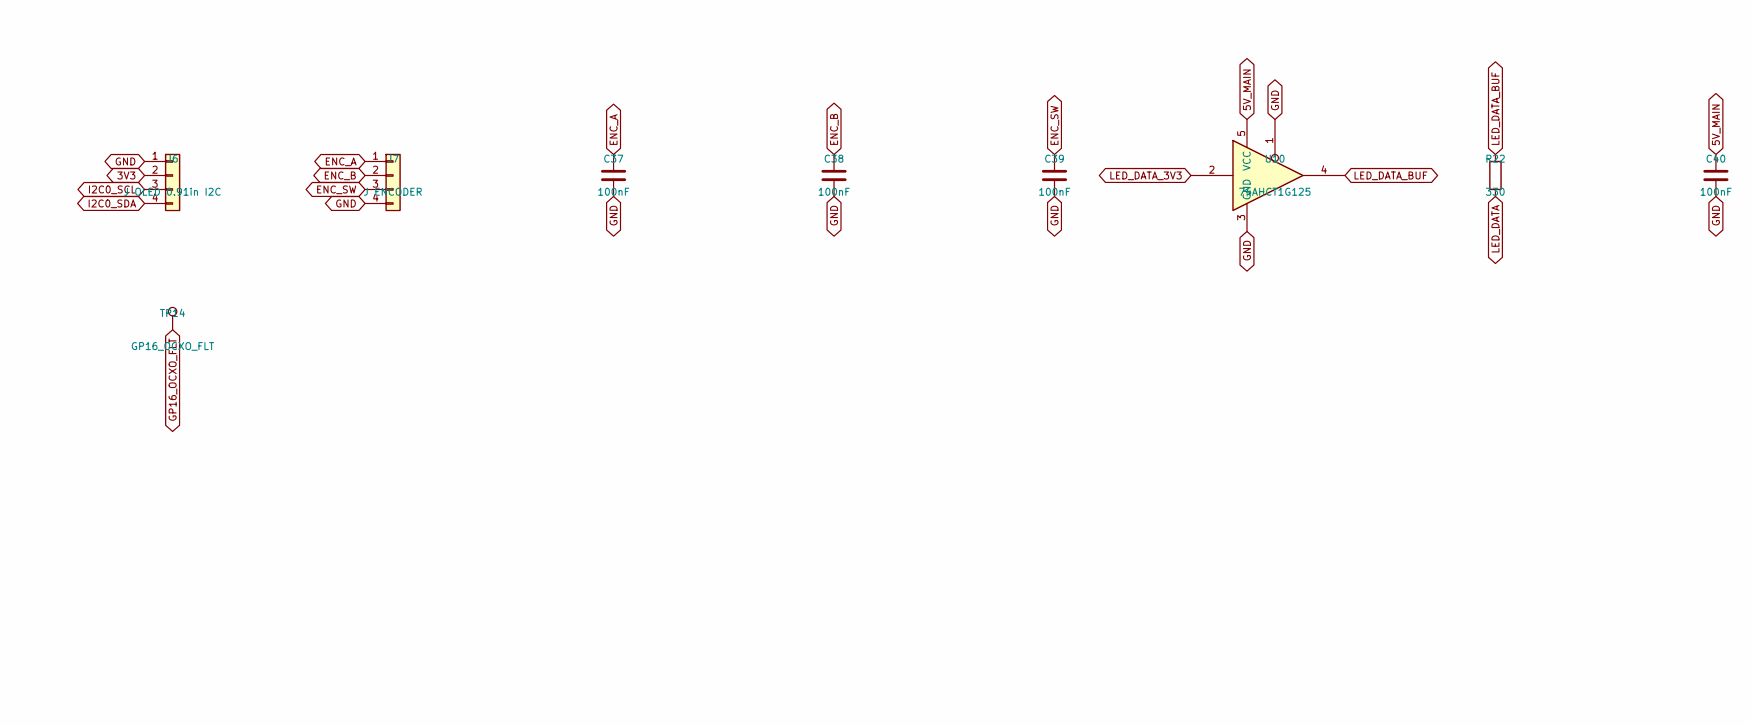
[picture p25: schematic mcu_ui.kicad_sch, part in row 1, column 2]

Parts:
A1: RP2350-Plus; RP2350-Plus_Castellated; MPN RP2350-Plus
C35: 10uF 10V; C_0805_2012Metric
C36, C37, C38, C39, C40: 100nF; C_0402_1005Metric
J6: J OLED 0.91in I2C; PinHeader_1x04_P2.54mm_Vertical
J7: J ENCODER; PinHeader_1x04_P2.54mm_Vertical
J8: J LEDS (2x WS2812B); PinHeader_1x03_P2.54mm_Vertical
J9: J RESET GNSS (short=reset); PinHeader_1x02_P2.54mm_Vertical
J10: J RUN (short=MCU reset); PinHeader_1x02_P2.54mm_Vertical
J11: J SPARE GPIO; PinHeader_1x07_P2.54mm_Vertical
R20, R21: 4.7k; R_0402_1005Metric
R22: 330; R_0402_1005Metric
TP14: GP16_OCXO_FLT; TestPoint_Pad_D1.5mm
U10: 74AHCT1G125; SOT-23-5; MPN SN74AHCT1G125DBVR

Connections:
3V3: A1.36 (3V3(OUT)), C35.1, C36.1, J6.2, J11.5, R20.2, R21.2; also elsewhere on the board
5V_MAIN: C40.1, J8.1, J11.7, U10.5 (VCC); also elsewhere on the board
ADC_5V: A1.31 (GP26); also elsewhere on the board
ADC_EFC: A1.34 (GP28); also elsewhere on the board
ADC_NTC: A1.32 (GP27); also elsewhere on the board
AUX_OEB: A1.20 (GP15); also elsewhere on the board
ENC_A: A1.15 (GP11), C37.1, J7.1
ENC_B: A1.16 (GP12), C38.1, J7.2
ENC_SW: A1.17 (GP13), C39.1, J7.3
GND: A1.3 (GND), A1.8 (GND), A1.13 (GND), A1.18 (GND), A1.23 (GND), A1.28 (GND), A1.33 (GND), A1.38 (GND), C35.2, C36.2, C37.2, C38.2, C39.2, C40.2, J6.1, J7.4, J8.3, J9.2, J10.2, J11.6, U10.1, U10.3 (GND); also elsewhere on the board
GNSS_EXTINT: A1.14 (GP10); also elsewhere on the board
GNSS_RESET: A1.12 (GP9), J9.1; also elsewhere on the board
GNSS_RXD: A1.1 (GP0); also elsewhere on the board
GNSS_TXD: A1.2 (GP1); also elsewhere on the board
GP16_OCXO_FLT: A1.21 (GP16), TP14.1
GP17: A1.22 (GP17), J11.1
GP18: A1.24 (GP18), J11.2
GP19: A1.25 (GP19), J11.3
GP20: A1.26 (GP20), J11.4
I2C0_SCL: A1.7 (GP5), J6.3, R21.1; also elsewhere on the board
I2C0_SDA: A1.6 (GP4), J6.4, R20.1; also elsewhere on the board
I2C1_SCL: A1.5 (GP3); also elsewhere on the board
I2C1_SDA: A1.4 (GP2); also elsewhere on the board
LED_DATA: J8.2, R22.2
LED_DATA_3V3: A1.19 (GP14), U10.2
LED_DATA_BUF: R22.1, U10.4
OCXO_10M_3V3: A1.10 (GP7); also elsewhere on the board
OCXO_EN: A1.27 (GP21); also elsewhere on the board
PPS_GNSS: A1.9 (GP6); also elsewhere on the board
PPS_MCU: A1.11 (GP8); also elsewhere on the board
RUN_MOD: A1.30 (RUN), J10.1
SYN_INTR: A1.29 (GP22); also elsewhere on the board
VBUS_MOD: A1.40 (VBUS); also elsewhere on the board
VSYS: A1.39 (VSYS); also elsewhere on the board

Notes on the sheet:
MCU + UI: Waveshare RP2350-Plus module soldered via castellated pads. GPIO map = docs v0.9 (GP16 = OCXO_FLT).

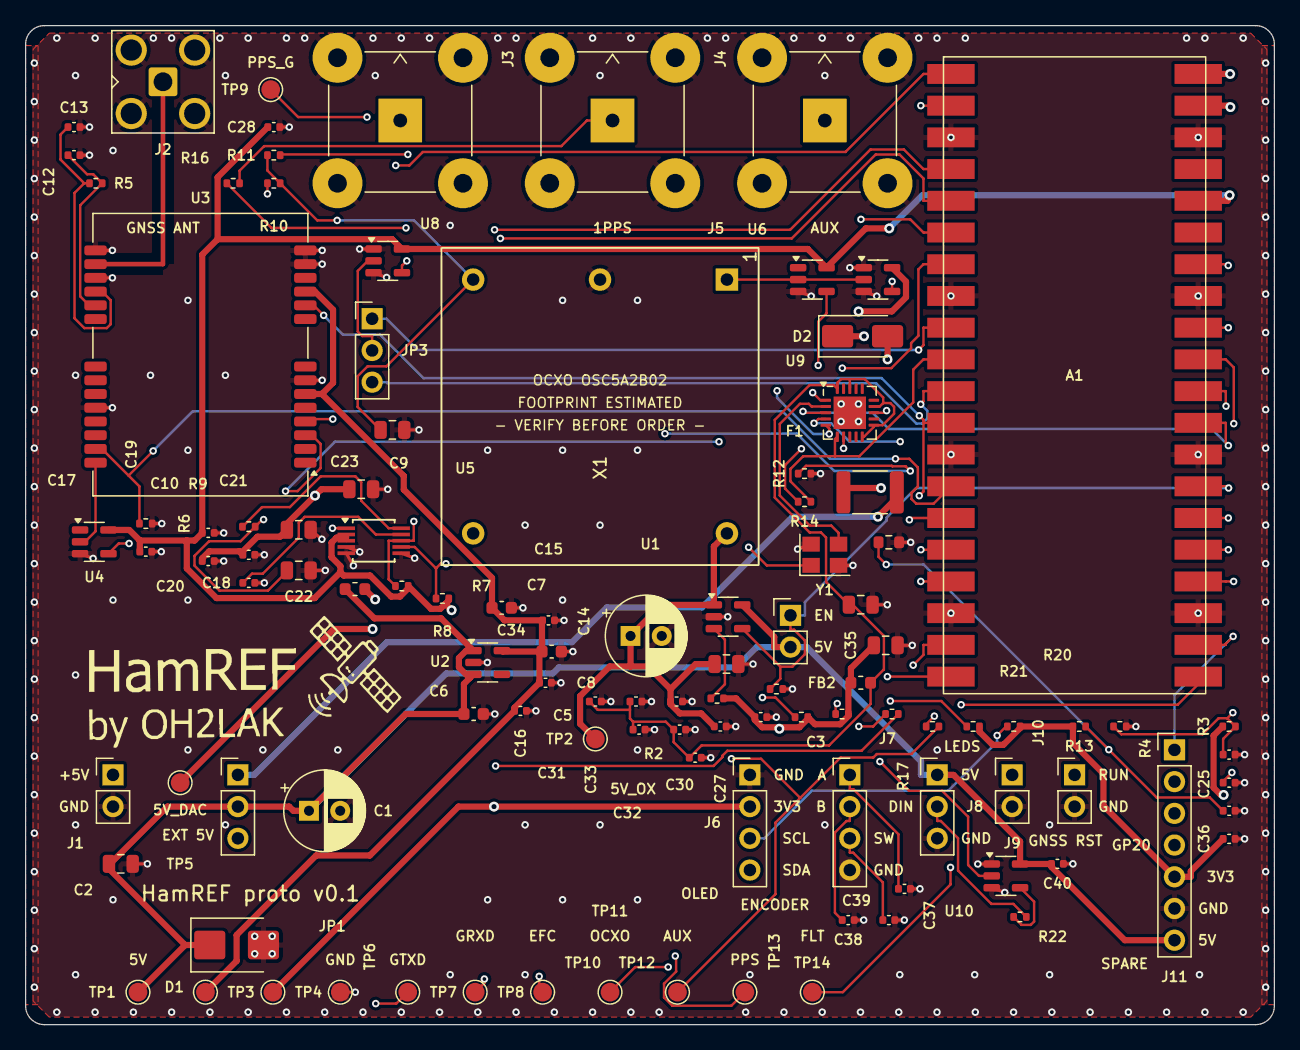
[picture p26: board hamref_proto_v0_1.kicad_pcb from above]

Board: 4 copper layers, 100.0 x 80.0 mm, 109 parts (0 on the bottom side), 60 nets.
