OH2LAK/HamRef/(commit log)

2026-09-21 Revise README for design and hardware updates
    Updated the README to reflect changes in the front panel design, including the addition of a rotary encoder and multicolor LEDs. Adjusted details about the enclosure and hardware decisions.
2026-10-14 Select RP2350 (Pico 2) as MCU and add architecture doc
    - README: switch MCU from ESP32-S3 to RP2350 (PIO-based 10 MHz counting and
    1PPS timestamping, native USB), update diagram, decisions table, roadmap
    - Add docs/architecture-and-plan.md (decision log, BOM categories, phases, risks)
    - Move datasheets from uBlox_LEA-M8S/ to docs/datasheets/
    - Add Fischer AKG 105.26 datasheet under enclosure/
    - Add docs/images, .gitignore and hardware/ + firmware/ placeholders
    Claude-Session: https://claude.ai/code/session_01BBEBh5Nhxyv6s49uszkplo
2026-10-14 Reorganize datasheets into per-vendor folders
    Move u-blox documents to docs/datasheets/uBlox and add an empty
    docs/datasheets/RPi_Pico_2 folder for Pico 2 / RP2350 documentation.
    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
2026-10-14 Add Raspberry Pi Pico 2 / RP2350 reference documents
    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
2026-10-14 Use a ready-made Pico 2 board and record RP2350 datasheet review
    HamREF is meant to be kit-like, so the MCU is a ready-made Pico 2 board
    rather than a custom RP2350 design. Architecture doc (v0.5) now records
    datasheet findings: 5 V tolerant GPIO, PIO for 10 MHz counting, errata
    E9/E12/E16, USB-C vs micro-USB and GPIO budget as open items.
    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
2026-10-14 Add OLED prototype module documentation and dimensions
    Store vendor images of the 0.91" 128x32 I2C OLED prototype module and
    record its real dimensions, pinout (GND/VCC/SCL/SDA), onboard LDO and
    pull-ups, and the lack of mounting holes in the architecture doc (v0.6).
    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
2026-10-14 Select Waveshare RP2350-Plus as USB-C board; add schematic/STEP and doc v0.8
    Claude-Session: https://claude.ai/code/session_01BBEBh5Nhxyv6s49uSZkpLo
2026-10-14 Add GPIO map and proto-PCB v0.1 requirements to architecture doc (v0.9)
    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
2026-10-14 Select CTI OSC5A2B02 as the prototype OCXO (doc v0.11)
    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
2026-10-14 Proto-PCB v0.1: KiCad schematics (generated), schematic plan, generator tools, doc v0.15
    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
2026-10-14 RP2350-Plus footprint: use official Pico 2 pad geometry (MIT)
    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
2026-10-14 RP2350-Plus footprint verified against Waveshare dimension drawing
    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
2026-10-14 Proto-PCB v0.1: placed and routed 4-layer board, PCB generator tools, doc v0.16
    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
2026-10-14 Proto-PCB v0.1: logo, silk cleanup, 3D model paths
    - Vectorised HamREF by OH2LAK logo + satellite from the enclosure mockup (make_logo.py)
    - silk_pass.py: place reference designators after routing, avoiding pads/vias/outlines
    - Fix 3D model paths for KiCad 10 (${KICAD10_3DMODEL_DIR}, .step); box models for OCXO and RP2350-Plus
    - route.sh: resume Freerouting from previous partial result; run silk pass before DRC
    - DRC: 0 unconnected, 0 clearance, no silk overlaps
    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
2026-10-14 Fix RP2350-Plus 3D box orientation (USB-C toward pin 1 end)
    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
2026-10-14 Proto-PCB v0.1: silk labels for connectors, jumpers and test points
    - silk_pass.py adds function and pin-name labels (J1, J6-J11, JP1-3), rear-panel names, TP net names
    - Reference designators avoid tracks where possible
    - Proto text moved under the logo
    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
2026-10-14 README: add proto-1 PCB image below the mockup, update status line
    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
2026-10-14 Proto-PCB v0.1: GND pours on all copper planes, edge via fence, stitching vias
    - F.Cu GND pour was missing (rule areas suppressed it in import_ses.py): fixed
    - gnd_finish.py: thermal-relief pours, RF no-pour strip along GNSS_RF, edge via fence, 6 mm stitching grid
    - route.sh: silk_pass then gnd_finish before DRC
    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
2026-10-14 Proto-PCB v0.1: fit Fischer AKG 105.26 case (100x80 mm)
    Board 100x100 -> 100x80 mm, R1.5 mm corners, no mounting holes (slides into
    case grooves), unmasked GND copper strips along both long edges, horizontal
    BNC/SMA connectors for the 15.2 mm height budget, router/test-point fixes.
    Docs updated to v0.18.
    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
2026-10-22 Add firmware PoC, board checklist, README cleanup
2026-11-03 README: document AUX OUT connector and Si5351C on the proto-1 board
    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
2026-11-03 README: use updated mockup and PCB images from docs/images
    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
